rohitrayana123/VLSI/README.md

VLSI
====

VLSI design project

Useful Things
-------------

Found this plug-in for Chrome that will make Bibtex references for you

https://chrome.google.com/webstore/detail/bibtex-entry-from-url/mgpmgkhhbjgkpnanlmlhibjfgpdpgjec
