rohitrayana123/VLSI/Reports/FinalReport/Control_Design.tex

\section{Controller}
\label{sec:controller}

The controller is a Mealy machine used to sequence operations performed on the datapath.
Figure~\ref{fig:ControlBlock} contains all inputs, outputs and internal registers.
There are $7$ labelled inputs including two $4$ bit buses and one $8$ bit bus.
There are $26$ labelled outputs including five $2$ bit buses and one $3$ bit bus.
Typedefs, defined in a global file, are used for some single bit outputs and all bus outputs to keep decoding consistent in control and the datapath. 
Inputs from the datapath also use typedefs as these are defined by the instruction set. 

\begin{figure}[t]
   \centering
    
		\caption{Inputs, outputs and internal registers of the control block.}% \todo[inline]{Maybe change to IEEE symbols if we have time, AJR: we still have the eagle d-types but I think it would look a bit messy} }
   \label{fig:ControlBlock}
\end{figure}

Three main states exist to service the fetch, execute and interrupt stages.
Five sub states are used within the main states to further coordinate operation.
The substate binary values are gray coded to avoid glitches in memory access.
The ASM chart in Figure~\ref{fig:MainStateASM} describes state changes using the sub state, current opcode and interrupt request signal.   
State machines linked to the main state in Figures~\ref{fig:FetchASM} and ~\ref{fig:ExecuteASM} described the substate transitions.
The pruned Verilog in Listing~\ref{lst:ControlOverview.sv} explains how nested case statements are used to describes large amounts of logical operations. 
When \textit{nReset} is asserted the machine will asynchronously return to the first cycle of the fetch state.

\begin{figure}[ht]
   \centering
    
		\caption{ASM chart of controller main states.}
		\label{fig:MainStateASM}
\end{figure}

\begin{minipage}{\linewidth}
\lstinputlisting[style=sverilog,label=lst:ControlOverview.sv,caption=Reduced Verilog of control unit combinatorial logic.]{Code/ControlOverview.sv}
\end{minipage}

\subsection{Fetch}

Fetching an instruction from memory requires placing the program counter on the address bus then reading the instruction in to the instruction register. 
The state machine described in Figure~\ref{fig:FetchASM} asserts signals associated with memory access and delays if the slow memory access input, \textit{nWait}, is set.
When the transition from \textbf{cycle3} to \textbf{cycle0} is made the main state machine, Figure~\ref{fig:MainStateASM}, also makes a transition therefore severing the link to this machine. 

\begin{figure}[ht]
   \centering
    
		\caption{ASM chart of sub state transitions in the fetch stage.}
		\label{fig:FetchASM}
\end{figure}

\subsection{Execute}

The instruction fetched from memory is decoded and executed in either $1$ or $4$ cycles.
This is a variable length stage dependant upon whether the instruction requires memory access.
After the instruction has been executed the \textit{IntReq} signal is checked to decide whether an interrupt has occurred.
If an interrupt has occurred the substate on exit is \textbf{cycle4} otherwise it is \textbf{cycle0} ready to perform another fetch. 

A large section of Listing~\ref{lst:ControlOverview.sv} contains control flow for output decoding in this stage.
The branch code is used during branch operations and also interrupt operations.
\begin{figure}[ht]
   \centering
    
		\caption{ASM chart of sub state transitions in the execute stage.}
		\label{fig:ExecuteASM}
\end{figure}

\subsection{Interrupt}

The circuit in Figure~\ref{fig:IntReqCircuit} is used to generate an interrupt request.
To avoid problems introduced by metastability the external \textit{nIRQ} signal is retimed using two D-types.
\textit{IntEnable} can only be set in code using the \textbf{ENAI} instruction.
\textit{IntDisable} is set when the processor is interrupted and also in code using the \textbf{DISI} instruction.
The end register contains \textit{IntStatus} which is low at reset therefore interrupts are off by default. 

\begin{figure}[ht]
   \centering
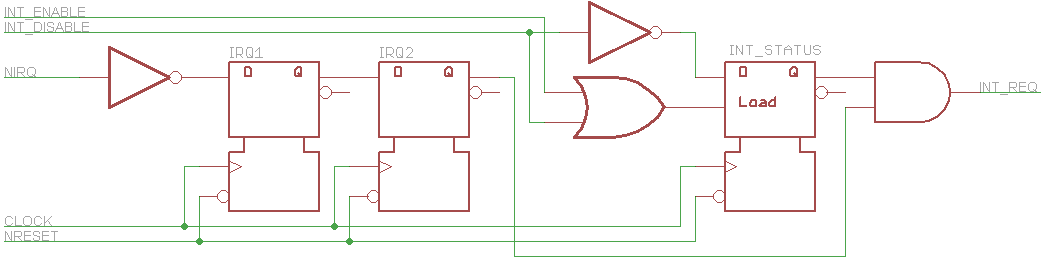
[picture p1: Reports/FinalReport/Figures/Interrupt.png]
    
		\caption{IntReq generation circuit.}
		\label{fig:IntReqCircuit}
\end{figure}

Entering an interrupt service routine (ISR) is completely handled in hardware. 
Interrupts are disabled and override functionality is used to decrement the stack pointer therefore allowing the program counter to be pushed to the stack.
The program counter is forced to address $0x0010$ which contains the code for ISR. 
The first operation in the ISR is \textbf{STF} which places the flags, located in the control unit, on the stack.

The penultimate operation in the ISR should be \textbf{LDF}. This loads the flags back in to the control unit.
This is similar to a \textbf{POP} operation but writes to the control unit instead of a general purpose register. 
The final operation is a \textbf{RETI} which again is similar to a \textbf{POP}, but writes to the program counter.

A bidirectional data interface to the control unit is required to facilitate these operations. 
Figure~\ref{fig:FlagCircuit} contains the circuit used to load and store flags inside the control unit.
The $4$ bit word containing the flags can be sourced from either the ALU or the bottom bits of \emph{SysBus}. 
When storing the flags in memory the output of the status register must be placed on \emph{SysBus} where the upper $12$ bits are all set to zero.

\begin{figure}[ht]
   \centering
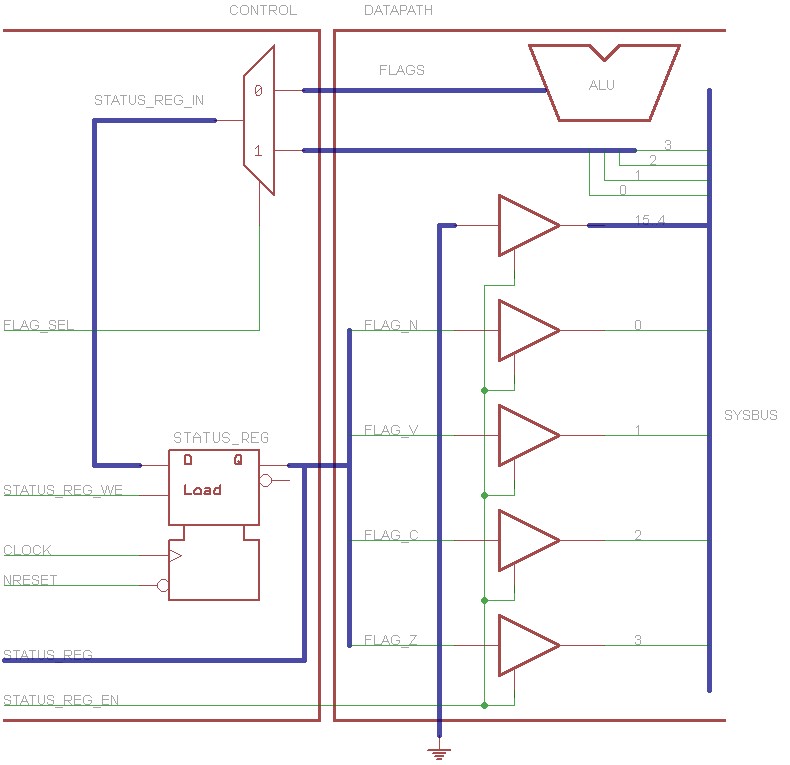
[picture p2: Reports/FinalReport/Figures/ControlIF.png]
    
		\caption{Control unit flag interface.}
		\label{fig:FlagCircuit}
\end{figure}

\subsection{Synthesis}

The controller was synthesised using Cadence Encounter. 
This provided a gate level netlist which was then used for place and route.
Both Magic and L-Edit place and route tools were used. 

The Magic place and route algorithm had a considerably larger routing channel than L-Edit algorithm as the cells were all placed in one long row. 
This was suboptimal as it resulted in a lot of dead space within the floorplan.

The L-Edit place and route provided far better results. 
The datapath and controller were approximately the same width. 
The I/Os were able to be positioned around the module to reduce the overall wiring needed in the full floor plan. 
Most of the datapath control signals were routed to the top of the module to reduce the wiring channel needed between the controller and datapath.
All the memory access signals were routed to the left of the controller to make easier connections to the pad ring. 
The controller was also connected to the low nibble of the input data. 
This was connected at the bottom of the controller to reduce wiring needed. 
Finally, decoder signals and flag inputs were routed to the right of the control.
