rohitrayana123/VLSI/Reports/FinalReport/Figures/MainStateASM.pdf

## Fetch

## Execute

## Interrupt

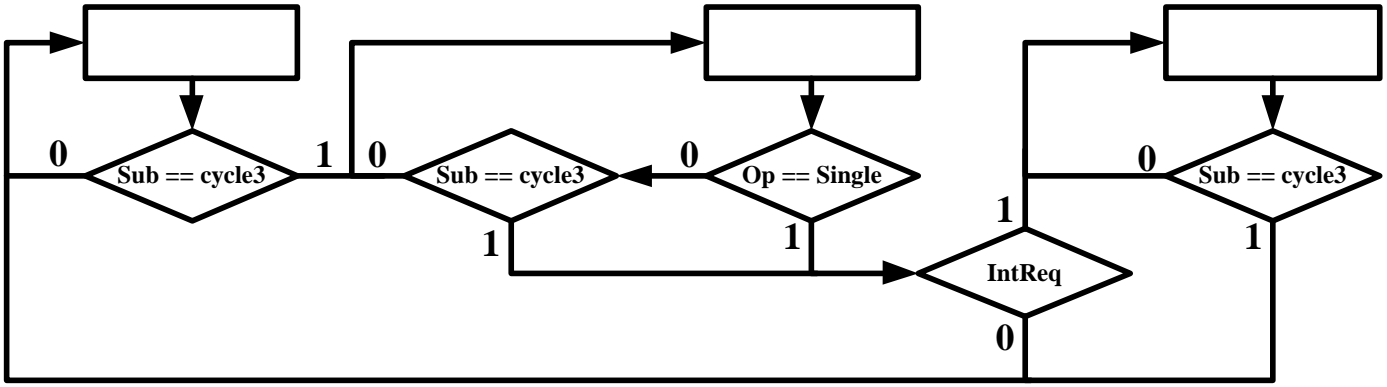
[picture p8: figure]
Sub == cycle3; Op == Single; IntReq; Sub == cycle3 0
