rohitrayana123/VLSI/Research/Subroutines/Subroutines.pdf

# ELEC6027: VLSI Design Project Part 1: Microprocessor Research Topic: Subroutines

### Ashley Robinson Team: R4 Course Tutor: Mr B. Iain McNally

### 18th February, 2014

## Contents

1 Introduction | 2
2 Research | 2
3 Case Studies | 4
4 Conclusion | 7
References | 9
Bibliography | 9

1

## 1 Introduction

Subroutines, also known as procedures, methods, functions or just routines, are smaller sections of code inside larger programs designed to perform specific tasks [2]. The motivation for subroutines is to produce code which is more efficient in size, easy to adapt and above all else maintain. They help form the foundations of third generation programming languages.
This report discusses the implications of subroutine support in hardware by considering microprocessor architecture and targeted assembler. Designing hardware such that it is capable of executing subroutines only requires available memory and access to the current position in the program; usually a register called the Program Counter (PC). Designing hardware to call and return from subroutines efficiently can vastly improve program performance. Two pieces of code will be referred to throughout this report. The caller is the piece of code which jumps to another piece of code and finally will return to continue execution. The callee is a piece of code jumped to from the caller and contains the functionality of a subroutine. While all subroutines considered a leaf functions the callee is not explicitly the whole subroutine as both pieces code are required for execution.

## 2 Research

### 2.1 Subroutine Context Save

Context save allows a microprocessor to switch execution focus but retain data such that the previous focus can be fully restored. Using call and return instructions when running a subroutine may automatically save context, such as the PC, but may also require additional instructions to guarantee safe execution. Nested and recursive subroutines, introduced in [4], require dealing with multiple context saves while retaining the data for all previous calls. Listing 1 holds subroutine written in C that recursively calls itself to compute the factorial of a number. Such applications require context save support that permits many nested subroutines.

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

Listing 1: Factorial subroutine

A stack, as discussed in [6], is a Last-In-First-Out (LIFO) data structure which is used for data storage when the immediately accessible registers do not provide enough memory. The stack can be thought of to grow in

2

size where a register called a Stack Pointer (SP) holds the address, in main memory, of the top most element. Two operations can be performed on the stack; push, which adds an item to the stack and increments the stack pointer, together with pull, which performs the reverse therefore shrinking the stack. It is convention for the stack to occupy main memory and grow down from the top address towards memory allocated for other purposes; this can be seen in figure 1. Data can be accessed indirectly on the stack using standard load and store instructions. If the top of the stack is known then relative addressing can be used to go back and forth without having to change the SP. Rewriting data in the stack is considered bad practice although is usually possible and can be exploited when writing subroutines.

Reserved

Text

Static data

Stack

0...0

F...F

SP

Dynamic data

Figure 1: Allocation of the stack in main memory. Based on a MIPS architecture adapted from [6].

Context save can also be handled by the assembler code running on the processor. Function prologues and epilogues, considered in [13, 9], are used to move data for safe execution. These follow conventions which usually advice the programmer on what register to place on the stack and how to do so from the caller and callee.

### 2.2 Operation of Stack Frames

A stack frame is a method of ordering data used when a subroutine is called. It is created by both the caller and the callee. It holds the paramters passed to the subroutine, the return address which should pointer at the caller and local variables created inside the callee. Figure 2 is a call stack; a stack of stack frames created by nesting subroutines. This is generally the case for most programs but optimisation can be used to improve memory allocation. Explained in [12], overlapping can be used to pass local variables on

3

to a nested subroutine by merging the parameter and local variable sections. Data returned from a function can be accessed using load instructions with addresses previously occupied by the stack.
Support for stack frames may be provided by a Base Pointer (BP). This usually takes on the value of the SP when the return address is placed on the stack therefore no calculations have to be done in order to destroy the local variable part of stack frame, just a simple overwrite.

Locals of FuncB

Return address

Parameters of FuncB

Locals of FuncA

Return address

Parameters of FuncA

To top of
stack

To bottom
of stack

Stack
frame for
FuncA
subroutine

Stack
frame for
FuncB
subroutine

Figure 2: An example call stack built of two stack frames where FuncA is called first. Adapted from [12].

## 3 Case Studies

### 3.1 Intel 8086

The Intel 8086 is a 16-bit Complex Instruction Set Computer (CISC) microprocessor which sparked the well kown x86 Intel family. It has support for procedure call instructions which automatically use the stack to organise data. The assembler held in listing 2 and 3 is written for the 8086. This is a basic example of how stack frames are built to pass parameters to and from a subroutine. The main program in listing 2 loads two immediate values into registers then begins building a stack frame by pushing them to the stack. The subroutine is called to act upon the arguments passed via the

4

stack. When control is passed back to the caller these set of instructions and the return value is extracted by using relative addressing from the BP then finally two stack pops completely destroy the stack frame. It is also possible to destroy the stack frame by using an add instruction on the SP shrinking it by one entry for every addition of two.

main : | ; Main l o o p
MOV | bp , sp | ; I n i t b a se p t r
MOV | ax , 4 2 | ; Load a r g 1
MOV | bx , 6 9 | ; Load a r g 2
PUSH | bx | ; Push a r g 1 t o s t a c k
PUSH | ax | ; Push a r g 2 t o s t a c k
CALL | adder | ; C all the s u b r o u ti n e
MOV | cx , [ bp−12] | ; Acce s s r e t u r n v al u e
POP | ax | ; R e s t o r e a l l r e g i s t e r s
POP | bx
JMP | main

Listing 2: 8086Caller.asm

When the subroutine, in listing 3, is called the return address is pushed onto the stack. This built-in support for the stack handles branching and next line address storage using a call function. To start the BP is placed on the stack so the SP has a restoration value. Reducing the value of the SP allocates space for local variables. The first argument is placed in memory as a local variable; this is unnecessary but serves as an example. The second argument is loaded into a working register. The first local variable is added to the working register which is then placed in to the memory as the second local variable. Finally the SP and the BP are restored and a return instruction hands control over to the caller. This is all part of the calling convention for subroutines using stack frames on the 8086 microprocessor [1].

adder PROC | | ; S u b r o u ti n e
PUSH | bp | ; Push b a se p t r t o s t a c k
MOV | bp , sp | ; Se t b a se p t r t o s t a c k p t r
SUB | sp , 4 | ; All o c a t e l o c a l v a r i a b l e sp ace ( 2 i n t s )
MOV | ax , [ bp+4] | ; Load a r g 1 i n t o Working
MOV | [ bp−2] , ax | ; Load a r g 1 i n t o L oc al 1
MOV | ax , [ bp+6] | ; Load a r g 2 i n t o Working
ADD | ax , [ bp−2] | ; Add t o c o n t e n t s o f working r e g
MOV | [ bp−4] , ax | ; Write L oc al 2 with r e s u l t
MOV | sp , bp | ; Return s t a c k p t r
POP | bp | ; R e s t o r e b a se p t r
RET | | ; Done
adder ENDP

Listing 3: 8086Callee.asm

5

This code was tested upon an 8086 emulator [11]. The emulator provides a complete overview of the flow of data within the processor including the stack. Figure 3a shows the emulator during the execution of the subroutine just before the SP is overwritten with the BP. Figure 3b is an abstraction of the stack with data labels corresponding to the subroutine.

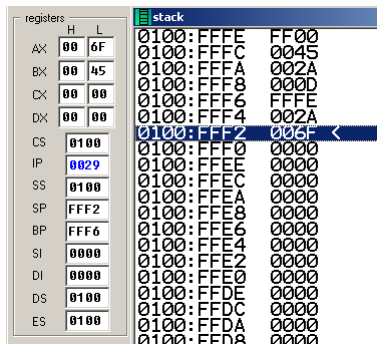
[picture p14: figure]

(a) Emulator registers and stack

arg2

arg1

PC

BP

local2

0xFFFC

0xFFFA

0xFFF8

0xFFF6

0xFFF4

Frame
Pointer

Stack
Pointer

local1

0xFFF2

0x0045

0x002A

0x000D

0xFFFE

0x002A

0x006F

(b) Stack frame configuration

Figure 3: 8086 stack operation

### 3.2 ARM7TDMI (using Arm Thumb)

The ARM7TDMI is a 32-bit Reduced Instruction Set Computer (RISC) microprocessor with an emphasis on low-power design and pipelining for high throughput which is detailed in [7]. It has two instruction sets. One of which is Arm Thumb, explained in [8], a low density compressed 16-bit subset of the ARM assembler language where the benefits are considered in [3]. It most notably assisted ARM into moving into the mobile phone market by reducing required program memory. A user selectable flag is set to switch between instruction sets.
This architecture does not have built-in support for calling subroutines using the stack. When the branch instruction is used, as seen in listing 4, the PC is overwritten with the address of the corresponding label. The address of the next line of code, which should be returned to after the subroutine, is placed into the link register (LR). Calling conventions suggests leaving this register untouched and simply moving the data back into the PC on a return.

6

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

Listing 4: ArmCaller.asm

In this case the LR is pushed onto the stack from the subroutine therefore requiring the subroutine to pop the value into the PC in order to return. This is an example of important assembler context save. If the prologue and epilogue are not respected then a call stack is never built therefore no nested functions can be used.
Listing 5 holds the subroutine and handles placing the return address on the stack. Relative addressing on the stack is required to draw the two arguments out and replace the first with the output of the function. Although this subroutine performs the same task as code held in listing 3 only one local variable is used as the example with two local variables is never really required.
adder PUSH | l r | ; Link r e g i s t e r h ol d s r e t u r n a d d r e s s
| SUB | sp , sp ,#4 | ; Make s p ace f o r l o c a l s on the s t a c k
LDR | r0 , [ sp ,# 1 2] | ; Get a r g 1 o f f s t a c k
LDR | r1 , [ sp ,# 8] | ; Get a r g 2 o f f s t a c k
| ADD | r0 , r0 , r 1 | ; Do the add
STR | r0 , [ sp ,# 0] | ; S t o r e the add a s a l o c a l
| ADD | sp , sp ,#4 | ; De s t roy l o c a l v a r i a b l e s p ace
| POP | pc | ; R e s t o r e program c o u n t e r and r e t u r n

Listing 5: ArmCallee.asm

## 4 Conclusion

It is clear that whether a microprocessor has built-in support for stack frames or not that the ability to call subroutines is unaffected. Support makes calling more efficient and easier to code. Essentially the matter is a trade off between complexity and efficiency.

7

### 4.1 Design Recommendations

All instruction sets considered in this report are 16-bits in length and could possibly be ported straight to the microprocessor to be designed. The 8086 is a pre-RISC architecture that can be considered as a quite a simple CISC processor [5]. RISC processors are simpler to construct as they have an emphasis on software; a comparison drawn in [10]. This would make the hardware easier to design but programs written for the end processor would be larger. So a RISC processor would most likely not provide built-in support for the stack but a CISC processor would; just like the case studies in section 3. A RISC processor is the intended architecture to implement the recommendation given is not to provide support but use instructions similar to those in the ARM Thumb instruction set. This would require designing an LR that can be used as shown in listings 4 and 3.

## References

[1] J. Archibald. The c calling convention and the 8086: Using the stack frame. http://ece425web.groups.et.byu.net/stable/labs/StackFrame.html, 2013. Online. Acessed Feb 2014.
[2] A. Chaney. | Subroutine. | https://www.princeton.edu/~achaney/
tmve/wiki100k/docs/Subroutine.html, Oct 2013. Online. Acessed Feb 2014.
[3] M. Hugue. Don’t we all need arms? http://www.cs.umd.edu/class/fall2001/cmsc411/proj01/arm/, 2001. Online, Acessed Feb 2014.
[4] B. I. McNally. Vlsi group design project: Programs. https://secure.ecs.soton.ac.uk/notes/bim/notes/fcde/assign/programs.html, Jan 2012. Online, Acessed Feb 2014.
[5] B. I. McNally. | Vlsi group design project: | Microprocessor re-
search. https://secure.ecs.soton.ac.uk/notes/bim/notes/fcde/assign/resdoc_14.html, 2014. Online, Acessed Feb 2014.
[6] D. Patterson and J. Hennessy. Computer Organization and Design, Fourth Edition, Fourth Edition: The Hardware/Software Interface (The Morgan Kaufmann Series in Computer Architecture and Design). Morgan Kaufmann, 4th edition, 2008. pp114–121.
[7] ARM Holdings plc. Arm7tdmi data sheet. http://www.ndsretro.com/download/ARM7TDMI.pdf, Aug 1995. Online. Acessed Feb 2014.

8

[8] ARM Holdings plc. | Thumb instruction set quick reference
card. | http://www.eng.auburn.edu/~nelson/courses/elec5260_
6260/Thumb%20Instructions.pdf, Oct 2003. | Online. Acessed Feb
2014.
[9] J. B. Pollard. | The gen on function perilogues. | http:
//homepage.ntlworld.com./jonathan.deboynepollard/FGA/ function-perilogues.html, 2010. Online, Acessed Feb 2014.
[10] R. Roberts. Risc vs cisc. http://cs.stanford.edu/people/eroberts/courses/soco/projects/risc/risccisc/, 2006. Online, Acessed Feb 2014.
[11] D. Sedory, R. Hyde, E. Isaacson, B. Allyn, T. Grysztar, S. Coval,
B. Brodt, J. Russell, and J. Gordonii. emu8086. http://www.emu8086.com/, 2013. Online. Acessed Feb 2014.
[12] Wikipedia. Call stack. http://en.wikipedia.org/wiki/Call_stack. Online, Acessed Feb 2014.
[13] Wikipedia. | Function prologue. | http://en.wikipedia.org/wiki/
Function_prologue. Online, Acessed Feb 2014.

## Bibliography

- ARM, Infocenter, http://infocenter.arm.com/help/index.jsp, Online. Acessed Feb 2014.
- A valuable resource for all things ARM.
- C. Lin, Understanding the Stack, http://www.cs.umd.edu/class/spring2003/cmsc311/Notes/Mips/stack.html, 2004, University of Maryland, Online. Acessed Feb 2014.
- General stack operation.
- S. Mathur, Microprocessor 8086: Architecture, Programming and Interfacing, PHI Learning Private Limited, 2011.
- Intel 8086 microprocessor resource
- B. I. McNally, Full Custom Design Exercise, http://users.ecs.soton.ac.uk/bim/notes/fcde/index.php, 2014.
- Plenty of information for ELEC6027

9

- D. Patterson and J. Hennessy, Computer Organisation and Design: The Hardware/Software Interface, Morgan Kaufman, 4th Edition, 2009.
- Lots of processor concepts and MIPS examples
- Wikipedia, MIPS architecture, http://en.wikipedia.org/wiki/MIPS_architecture, Online. Acessed Feb 2014.
- Quick information on the well studied MIPS processor.

10
