rohitrayana123/VLSI/Emulators/emu8086/binaries/readme.txt

	emu

        shareware, see licence.html

	yurim@nana10.co.il
