rohitrayana123/VLSI/Reports/FinalReport/CPU_Design.tex

%  CPU_Design.tex
%  Document created by seblovett on seblovett-Ubuntu
%  Date created: Thu 17 Apr 2014 15:14:45 BST
%  <+Last Edited: Thu 17 Apr 2014 15:36:00 BST by seblovett on seblovett-Ubuntu +>

\section{CPU}

%Overall layout 

The datapath and the control units were designed to allow them to connect together with as small a wiring channel as possible. 
All the I/Os were placed in each of the blocks to minimize the routing between the module and the pad ring. 
The pad ring used had a core size of $1505.00\mu m \times 1500.70\mu m$. 
The total size of the chip including the pad ring is $ 2150.00\mu m \times 2145.70\mu m$, a total area of $4.6mm^2$.

The controller was positioned below the datapath as it needed a connection to the lowest nibble of the system bus. 
The control signals between the datapath and controller were then placed to minimise the routing between them. 
This placement is at the expense of some control signals being routed to above the datapath. 

A net list was created and the magic autorouter was used.
This routed all the signals between the controller, datapath and the pad ring. 
The power lines were routed manually to the correct sizes. 

A large amount of polysilicon and the name of the processor, \textsc{Samurai}, is placed in the routing channels of the CPU to satisfy the design rule checks. 
A N-ohmic guard ring is also placed around the design and is connected to the core supply.
A large block of not\_pwell paint is used to explicitly define all undefined areas.
