rohitrayana123/VLSI/Documents/DeclarationofSpecialisms.pdf

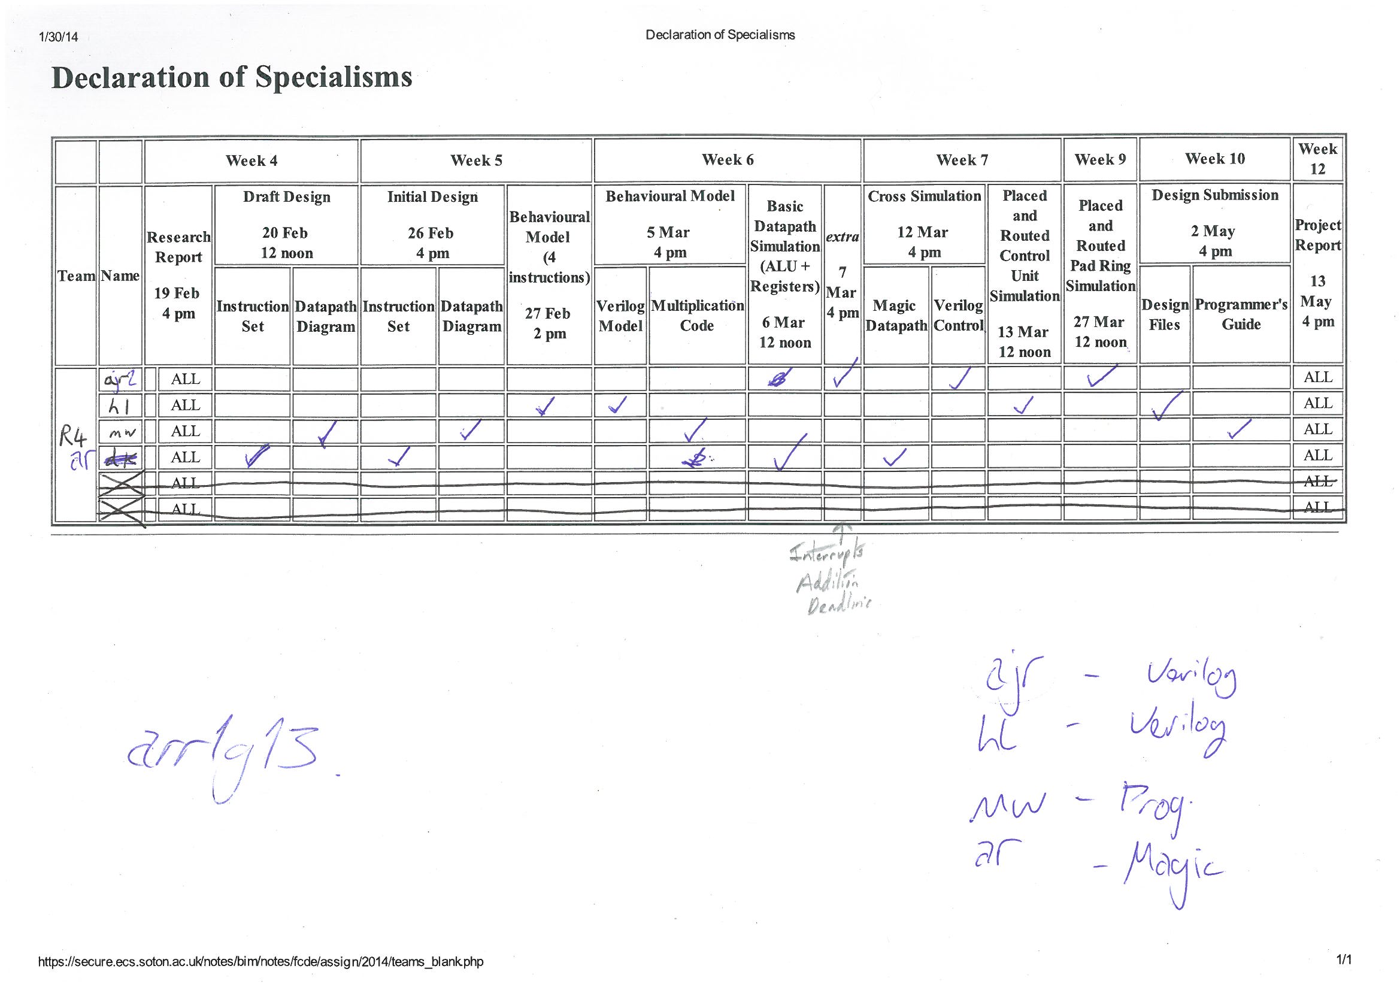
[picture p25: page 1]
