rohitrayana123/VLSI/Reports/FinalReport/ISSummary_page1.pdf

Mnemonic Syntax | Semantics | Flags Encoding Opcode Cond.
1 | ADD | ADD Rd, Ra, Rb | Rd ← Ra + Rb | c,v,n,z | A | 00010 | -
2 | ADDI | ADDI Rd, Ra, #imm5 | Rd ← Ra + imm5 | c,v,n,z | A | 00110 | -
3 | ADDIB | ADDIB Rd, #imm8 | Rd ← Rd + imm8 | c,v,n,z | B | 00011 | -
4 | ADC | ADC Rd, Ra, Rb | Rd ← Ra + Rb + c | c,v,n,z | A | 00100 | -
5 | ADCI | ADCI Rd, Ra, #imm5 | Rd ← Ra + imm5 + c | c,v,n,z | A | 00101 | -
6 | NEG | NEG Rd, Ra | Rd ← 0 - Ra | c,v,n,z | A | 11010 | -
7 | SUB | SUB Rd, Ra, Rb | Rd ← Ra - Rb | c,v,n,z | A | 01010 | -
8 | SUBI | SUBI Rd, Ra, #imm5 | Rd ← Ra - imm5 | c,v,n,z | A | 01110 | -
9 | SUBIB | SUBIB Rd, #imm8 | Rd ← Rd - imm8 | c,v,n,z | B | 01011 | -
10 | SUC | SUC Rd, Ra, Rb | Rd ← Ra - Rb - c | c,v,n,z | A | 01100 | -
11 | SUCI | SUCI Rd, Ra, #imm5 | Rd ← Ra - imm5 - c | c,v,n,z | A | 01101 | -
12 | CMP | CMP Ra, Rb | Ra - Rb | c,v,n,z | A | 00111 | -
13 | CMPI | CMPI Ra, #imm5 | Ra - imm5 | c,v,n,z | A | 01111 | -
14 | AND | AND Rd, Ra, Rb | Rd ← Ra AND Rb | - | A | 10000 | -
15 | OR | OR Rd, Ra, Rb | Rd ← Ra OR Rb | - | A | 10001 | -
16 | XOR | XOR Rd, Ra, Rb | Rd ← Ra XOR Rb | - | A | 10011 | -
17 | NOT | NOT Rd, Ra | Rd ← NOT Ra | - | A | 10010 | -
18 | NAND | NAND Rd, Ra, Rb | Rd ← Ra NAND Rb | - | A | 10110 | -
19 | NOR | NOR Rd, Ra, Rb | Rd ← Ra NOR Rb | - | A | 10111 | -
20 | LSL | LSL Rd, Ra, #imm4 | Rd ← Ra << imm4 | - | A | 11111 | -
21 | LSR | LSR Rd, Ra, #imm4 | Rd ← Ra >> imm4 | - | A | 11101 | -
22 | ASR | ASR Rd, Ra, #imm4 | Rd ← Ra >>> imm4 | - | A | 11100 | -
23 | LDW | LDW Rd, [Ra, #imm5] | Rd ← Mem[Ra + imm5] | - | C | 00000 | -
24 | STW | SDW Rd, [Ra, #imm5] | Mem[Ra + imm5] ← Rd | - | C | 01000 | -
25 | LUI | LUI Rd, #imm8 | Rd ← {imm8, 0} | - | B | 10100 | -
26 | LLI | LLI Rd, #imm8 | Rd ← {Rd[15:8], imm8} | - | B | 10101 | -
27 | BR | BR LABEL | PC ← PC + imm8 | - | D | - | 000
28 | BNE | BNE LABEL | (z==0)? PC ← PC + imm8 | - | D | - | 110
29 | BE | BE LABEL | (z==1)? PC ← PC + imm8 | - | D | - | 111
30 | BLT | BLT LABEL | (n&~v OR ~n&v)? PC ← PC + imm8 | - | D | - | 100
31 | BGE | BGE LABEL | (n&v OR ~n&~v)? PC ← PC + imm8 | - | D | - | 101
32 | BWL | BWL LABEL | LR ← PC + 1; PC ← PC + imm8 | - | D | - | 011
33 | RET | RET | PC ← LR | - | D | - | 010
34 | JMP | JMP Ra, #imm5 | PC ← Ra + imm5 | - | D | - | 001
| | PUSH Ra | Mem[R7] ← Ra; R7 ← R7 - 1;
| | PUSH LR | Mem[R7] ← RL; R7 ← R7 - 1;
| | POP Ra | R7 ← R7 + 1; Ra ← Mem[R7]
| | POP LR | R7 ← R7 + 1; RL ← Mem[R7]
37 | RETI | RETI | PC ← Mem[R7] | - | F | - | 000
38 | ENAI | ENAI | IntEnFlag ← 1 | - | F | - | 001
39 | DISI | DISI | IntEnFlag ← 0 | - | F | - | 010
40 | STF | STF | Mem[R7] ← Flags; R7 ← R7 - 1; | - | F | - | 011
41 | LDF | LDF | R7 ← R7 + 1; Mem[R7] ← Flags; | - | F | - | 100
E | - | -
E | - | -

35

36

PUSH

POP
