rohitrayana123/VLSI/Design/RandD/ajr_datapath.pdf

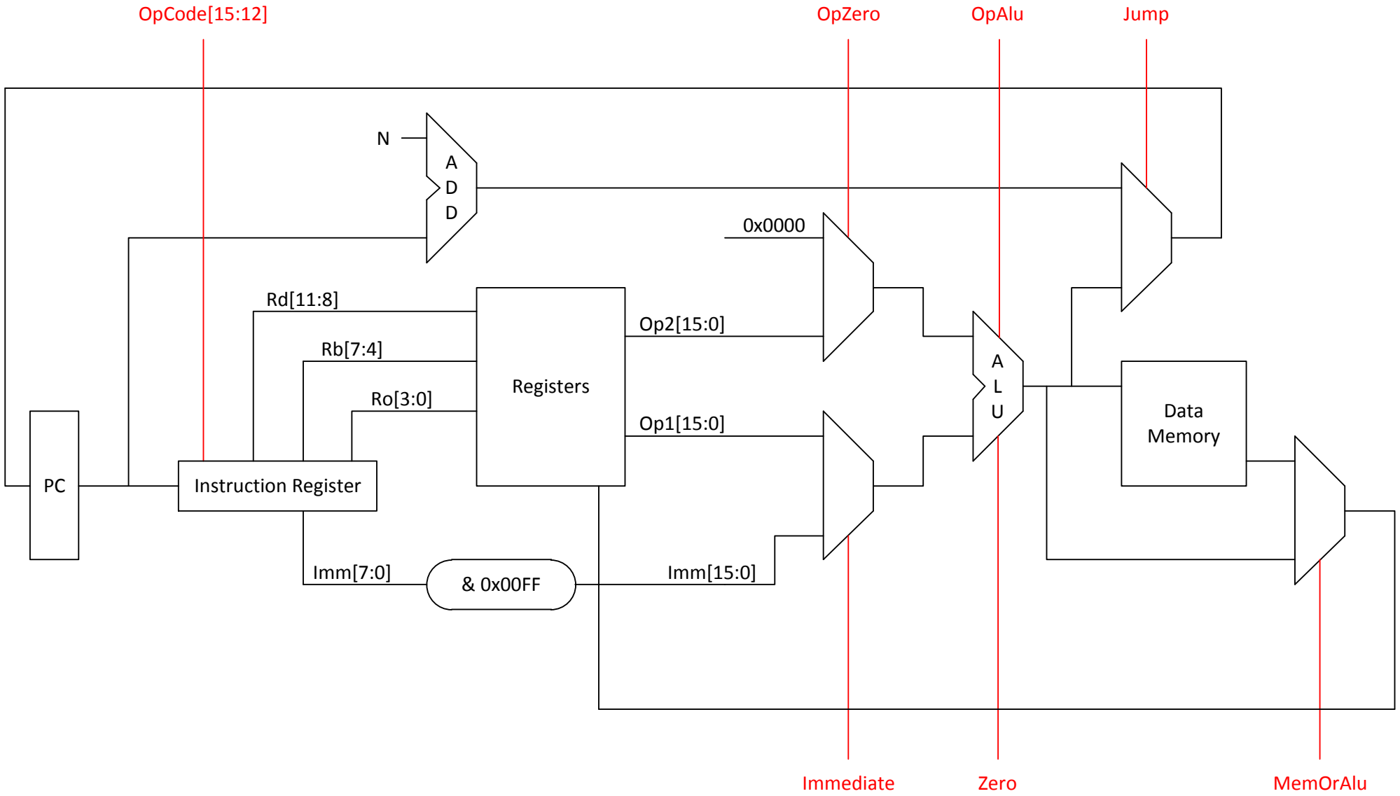
[picture p37: figure]
Registers; Data Memory; MemOrAlu; Jump; Zero; Instruction Register; OpCode[15:12]; Immediate; Imm[7:0]; OpZero; OpAlu; Imm[15:0] & 0x00FF
