rohitrayana123/VLSI/Reports/FinalReport/Figures/ExecuteASM.pdf

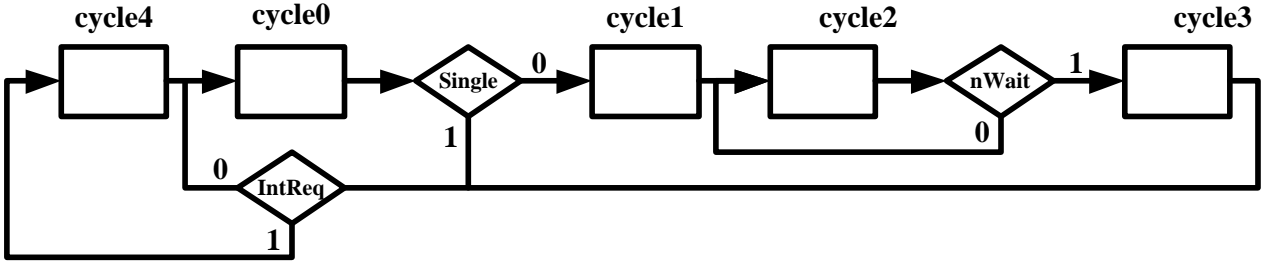
[picture p38: figure]
