rohitrayana123/VLSI/Reports/FinalReport/Figures/ControlPinout.pdf

O
p

c

o

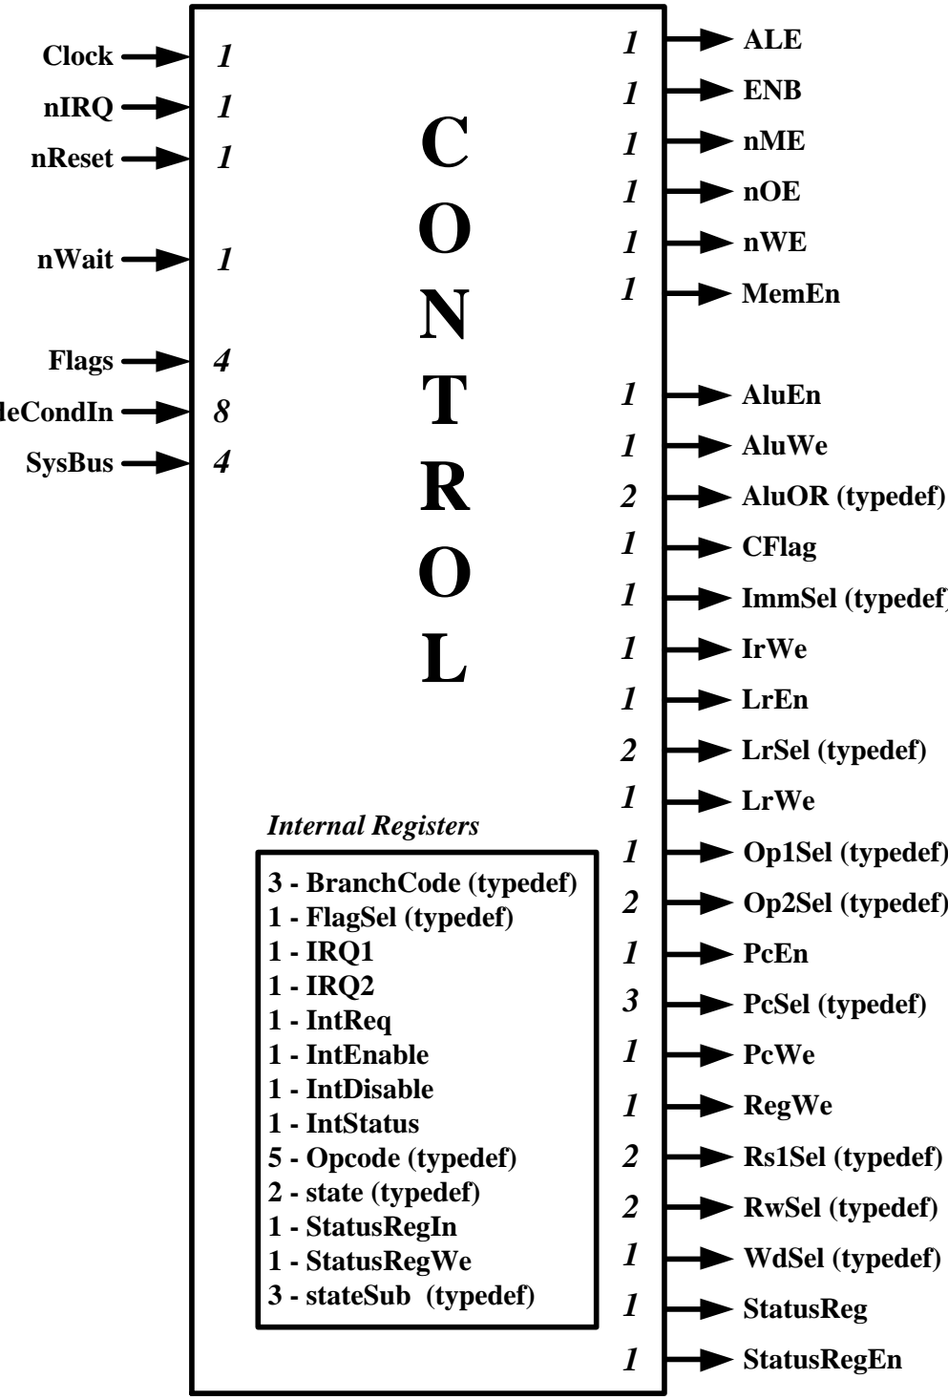
[picture p39: figure]
CONTROL

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
