rohitrayana123/VLSI/Research/Subroutines/Figures/Allocation.pdf

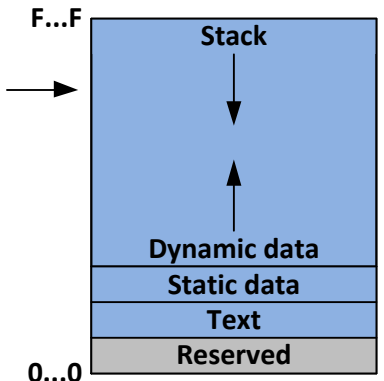
[picture p40: figure]
Reserved; Text; Static data; Stack; Dynamic data

0...0

SP
