rohitrayana123/VLSI/Design/RandD/henry_VNM_1.jpg

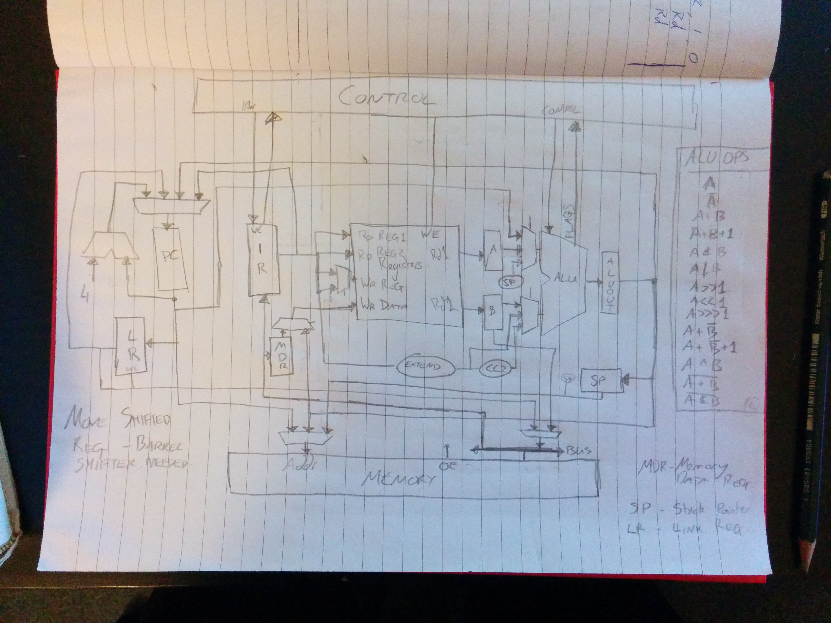
Design/RandD/henry_VNM_1.jpg
