rohitrayana123/VLSI/eagle/Datapath/datapath.png

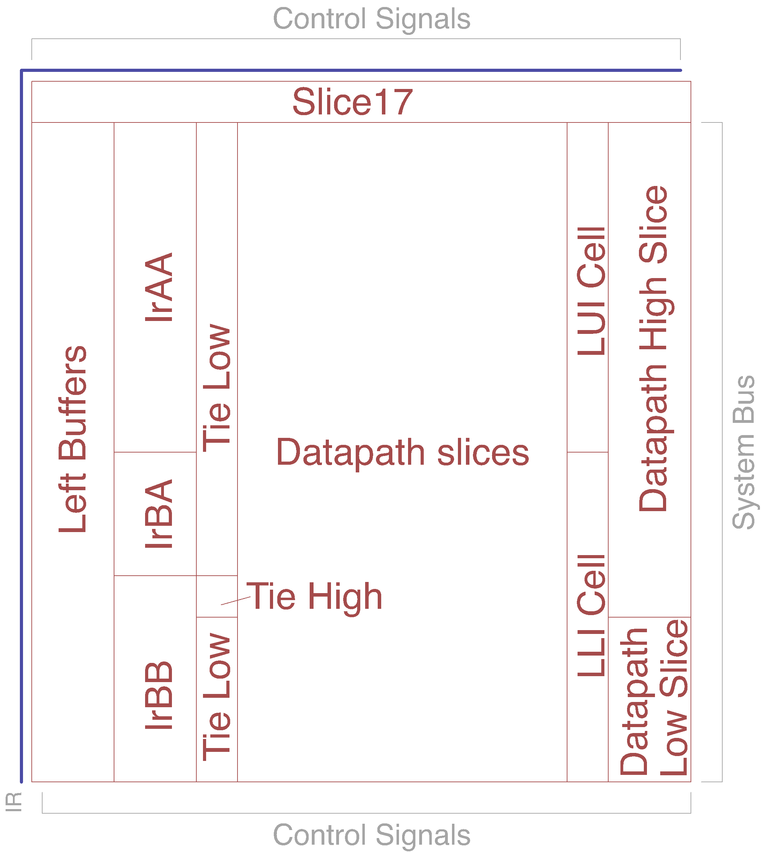
eagle/Datapath/datapath.png
