rohitrayana123/VLSI/Reports/FinalReport/Figures/ALUDecoderGateArray.png

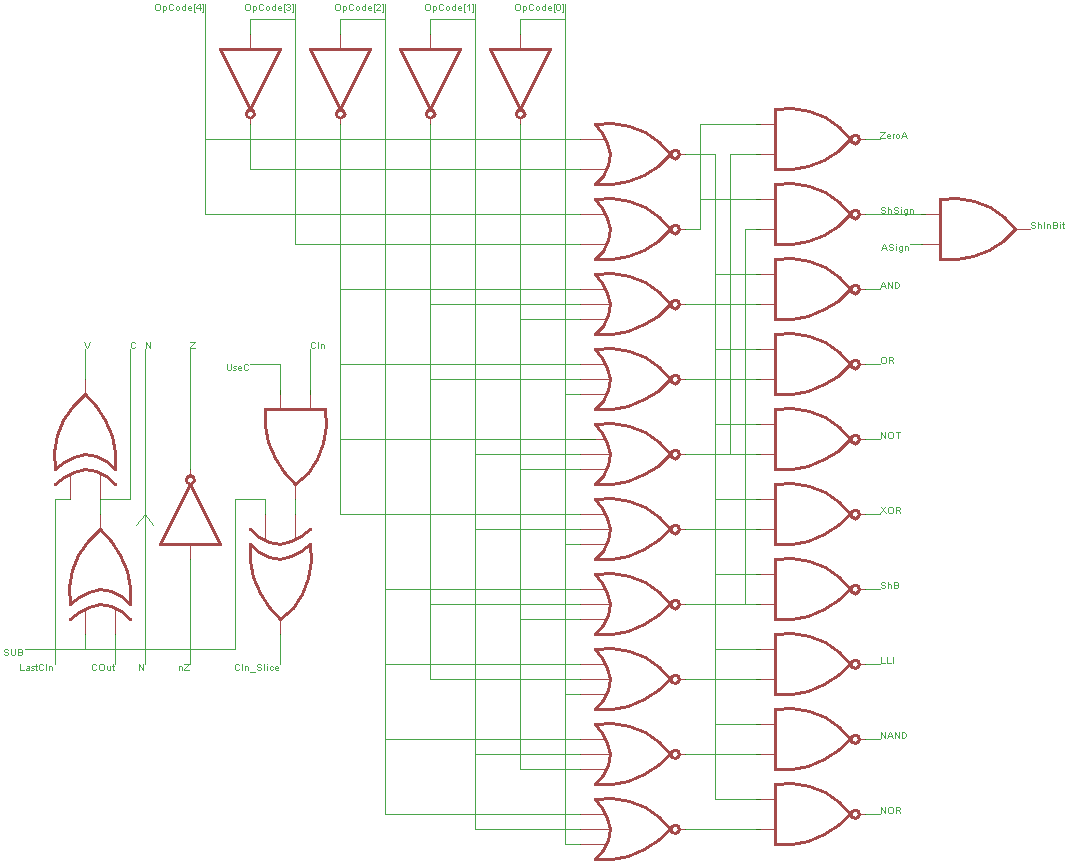
Reports/FinalReport/Figures/ALUDecoderGateArray.png
