rohitrayana123/VLSI/Reports/FinalReport/Figures/ALUDecoderMore1.png

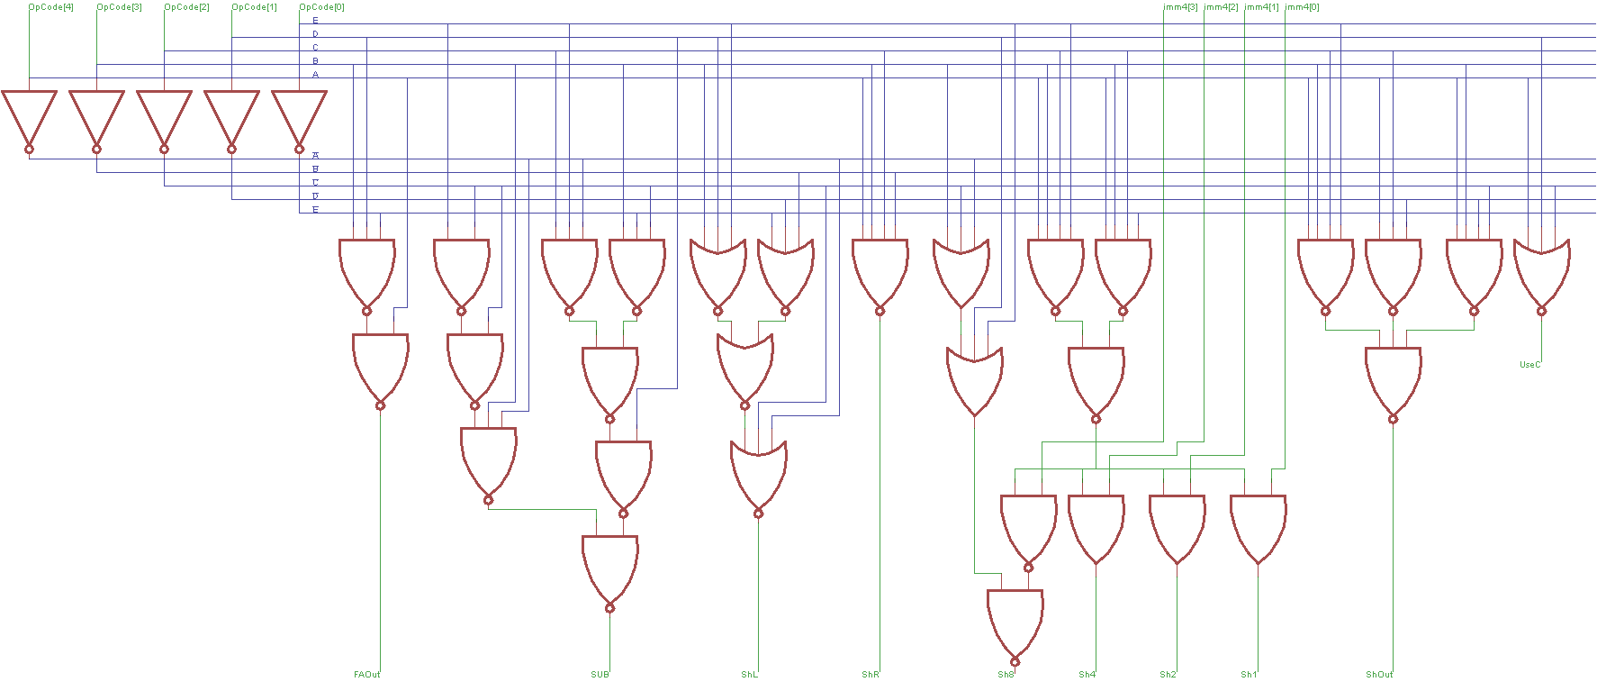
Reports/FinalReport/Figures/ALUDecoderMore1.png
