rohitrayana123/VLSI/Reports/FinalReport/Figures/LLILSlice.png

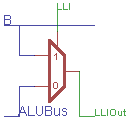
Reports/FinalReport/Figures/LLILSlice.png
