rohitrayana123/VLSI/Reports/ProgGuide/CodeListings.tex

\section{Code Listings}
All code listed in this section is passed to the assembler \emph{as is} and has been verfied using the final design of the processor.
\subsection{Multiply}
\label{sec:multiply_appendix}
\lstinputlisting[style=asm,label=lst:multiply.asm,caption=multiply.asm]{../../Design/Implementation/programs/multiply.asm}
%\subsection{Multiply Unrolled}
%\label{sec:multiply_unrolled_appendix}
%\lstinputlisting[style=asm,label=lst:multiplyUnroll.asm,caption=multiplyUnroll.asm]{../../Design/Implementation/programs/multiplyUnroll.asm}
\subsection{Factorial}
\label{sec:factorial_appendix}
\lstinputlisting[style=asm,label=lst:factorial.asm,caption=factorial.asm]{../../Design/Implementation/programs/factorial.asm}
\subsection{Random}
\label{sec:random_appendix}
\lstinputlisting[style=asm,label=lst:random.asm,caption=random.asm]{../../Design/Implementation/programs/random.asm}
\subsection{Interrupt}
\label{sec:interrupt_appendix}
\lstinputlisting[style=asm,label=lst:interrupt.asm,caption=interrupt.asm]{../../Design/Implementation/programs/interrupt.asm}
