rohitrayana123/VLSI/Reports/ProgGuide/ProgGuide.tex

%  ProgGuide.tex
%  Document created by seblovett on hind.ecs.soton.ac.uk
%  Date created: Thu 27 Mar 2014 10:09:06 GMT
%  <+Last Edited: Fri 02 May 2014 09:46:39 BST by seblovett on seblovett-Ubuntu +>

\documentclass[twoside,12pt]{article}

%\usepackage[nodayofweek]{datetime}
\usepackage{ISFormat}
\usepackage{multirow}
\usepackage[colorinlistoftodos,disable]{todonotes}
\usepackage[nodayofweek]{datetime}
\usepackage{listings}
\usepackage{graphicx}
\usepackage{titlesec}
\newcommand{\sectionbreak}{\cleardoublepage}
\usepackage[all]{background}
\usepackage{lipsum}
\usepackage{tikz}
\usetikzlibrary{calc}
\usepackage{changepage}
\usepackage{subfigure}
\graphicspath{{Figures/}}
\author{Team R4\\
Henry Lovett (hl13g10)\\ 
Ashey J. Robinson (ajr2g10)\\
Martin Wearn (mw20g10)\\
Anusha R. Reddy (arr1g13)\\ \\
Course Tutor: Mr B. Iain McNally\\ \\}

\title{ELEC6027 - VLSI Design Project \\ Programmers Guide}

\begin{document}
\maketitle
\thispagestyle{empty}
\input{definitions.tex}%import some definitions
\clearpage
%\listoftodos
%\todo[inline]{Run a spell check on all files}
%\begin{abstract}
%Abstract
%\end{abstract}
\cleardoublepage
\tableofcontents
\cleardoublepage
\input{Introduction.tex}
\input{Architecture.tex}
\input{RegDescription.tex}
\input{InstructionSet.tex}
\input{ProgrammingTips.tex}
\input{Assembler.tex}
\input{Programs.tex}
%\input{Simulation.tex}
\input{Simulation_SimPy.tex}
\newpage
\appendix
\input{CodeListings.tex}
\input{DeclarationofWork.tex}
\end{document}
