rohitrayana123/VLSI/Reports/ProgGuide/DeclarationofWork.tex

%  DeclarationofWork.tex
%  Document created by seblovett on seblovett-Ubuntu
%  Date created: Tue 29 Apr 2014 20:51:04 BST
%  <+Last Edited: Tue 29 Apr 2014 21:07:39 BST by seblovett on seblovett-Ubuntu +>

\section{Declaration of Work}

Table~\ref{tab:work} shows the break down of the work for this programming guide. 
Where multiple team members contributed to a section, approximate work percentages are given. 

\begin{table}[!h]
\caption{Work Breakdown for the Programmers Guide}
\label{tab:work}
\centering
\begin{tabular}{|c|c|} \hline
Chapter			&	User	\\ \hline
Introduction		&	hl13g10 \\	
Register Description	&	arr1g13 (50\%), hl13g10 (50\%) \\
Instruction Set		&	mw20g10	\\
Programming Tips	&	ajr2g10 (50\%), hl13g10 (50\%) \\		
Assembler		&	mw20g10 (75\%), hl13g10 (50\%) \\		
Programs		&	ajr2g10 \\
Simulation		&	hl13g10 \\
Code Listings		&	ajr2g10 \\ \hline
\end{tabular}
\end{table}
