rohitrayana123/VLSI/Design/InstructionSet/EncodingGuide.txt

This is the coding scheme I used when writing up the instruction set.

OpCodes:
	See KMap

Conditions:
Unconditional starts 0
	a 0 next uses link register
	a 1 next does not use link register
Conditional starts 1
	a 1 next checks z flag
	a 0 next does not check z flag
