rohitrayana123/VLSI/Reports/ProgGuide/Figures/twoStack.pdf

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
## RR0 R1 R2 R3 R4

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
