rohitrayana123/VLSI/Research/InstructionSet/8086Format_cropped.pdf

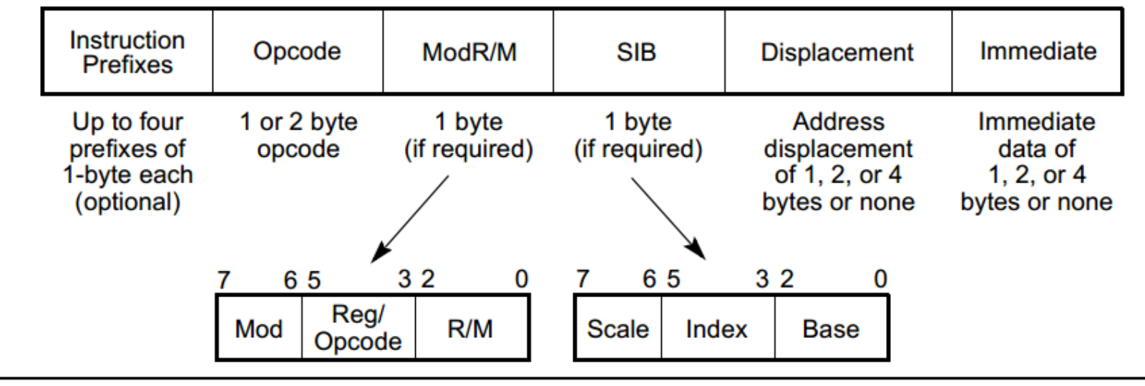
[picture p50: page 1]
