rohitrayana123/VLSI/Research/InstructionSet/AlphaFormat_cropped.pdf

Opcode | | | | | PAL code
Opcode | RA | | | | Branch
Opcode | RA | RB | | | Memory
Opcode | RA | RB | Func | RC | Operate
6 | 5 | 5 | 11 | 5 | Bit Count

Number
| Disp
| | Disp
