rohitrayana123/VLSI/Research/InstructionSet/Correlations_cropped.pdf

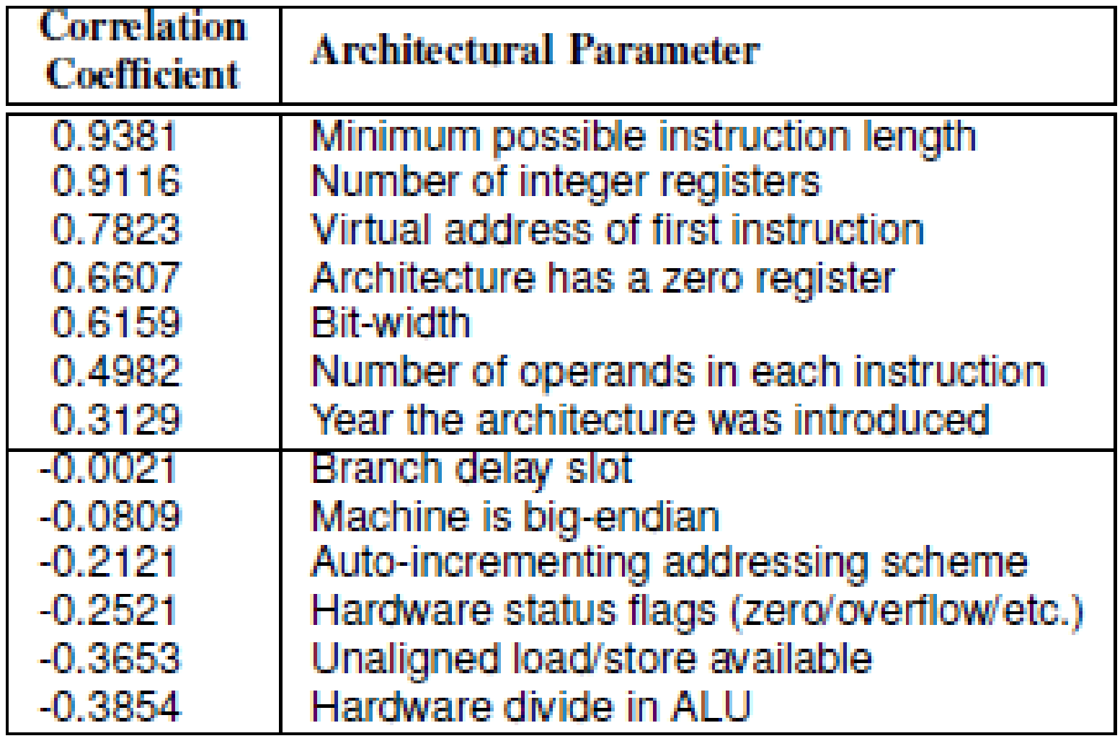
[picture p51: page 1]
