rohitrayana123/VLSI/Reports/FinalReport/PC_Test.tex

%  PC_Test.tex
%  <+Last Edited: Mon 12 May 2014 10:18:05 BST by seblovett on seblovett-Ubuntu +>

\section{Program Counter}
%\todo[color=cyan, inline]{Include Sub tests - of slice and decoder (if app)}
%\todo[color=cyan, inline]{Explain tests - what is done}
%\todo[color=cyan, inline]{why it is done.}
%\todo[color=cyan, inline]{How it verifies everything - why it is complete}
%\todo[color=cyan, inline]{Show simulation results}

This module contains both the program counter and link register, which could be tested independently by checking the response to different select signals. The PC was tested by setting \textit{PcSel} to each possible value, then causing a change in the value of that input to ensure the value of PC reflects the change. This covers incrementing, \textit{SysBus}, \textit{AluOut} and constant inputs. 
\todo[inline]{Extend tests for load from LR}

The link register was then tested in the same manner for loading from \textit{SysBus} and an incremented program counter value. 
The value of each register was read from the system bus with assertions to ensure correct behaviour. 

\incomplete{PC block test}
