rohitrayana123/VLSI/Reports/FinalReport/Register_Test.tex

%  Register_Test.tex
%  <+Last Edited: Mon 12 May 2014 10:26:45 BST by seblovett on seblovett-Ubuntu +>

\section{Register Block}

%Include Sub tests - of slice and decoder (if app)
Tests were implemented for the decoder and bitslice modules implemented in Magic. 
A full module test was also written. 
The same test was designed to be run on both the Magic layout and the behavioural SystemVerilog design. 
This allowed the full operation of the behavioural model and implemented layout to be verified to the same standard. 

The bitslice test loads one bit of data into each register, and checks that it can be read back on each of the data read lines.
Assertions are used to automate the checking of the bit slice.

The decoder is verified by exercising all the possible inputs to each of the decoders.
The one hot encoding output is then checked to be as expected for the current input. %correct to the input.
This is repeated for each read decoder, and the write decoder is verified to only output correctly when the write enable signal is high. 

The full test uses a ``task'' code block to write to a register and read the data back.
The data is then verified to be correct on both read ports.
This process is repeated 100 times to exercise different data on all the registers. 
Assertions are used to give a final pass/fail result allowing quick verification of the module.
The tests ensure the read buffers and the writing to each register is fully functional.

%why it is done.

%How it verifies everything - why it is complete
