rohitrayana123/VLSI/Reports/FinalReport/Testing.tex

%  Testing.tex
%  Document created by seblovett on seblovett-Ubuntu
%  Date created: Thu 17 Apr 2014 15:23:39 BST
%  <+Last Edited: Thu 17 Apr 2014 17:34:00 BST by seblovett on seblovett-Ubuntu +>

\chapter{Testing}

\input{Register_Test.tex}
\input{PC_Test.tex}
\input{IR_Test.tex}
\input{ALU_Test.tex}
\input{Datapath_Test.tex}
\input{Control_Test.tex}
\input{CPU_Test.tex}
