rohitrayana123/VLSI/Reports/FinalReport/TestResults.tex

\chapter{Test Results}

\section{ALU Results}
\label{chap:ALUTestResults}

\begin{figure}[h]
	\centering
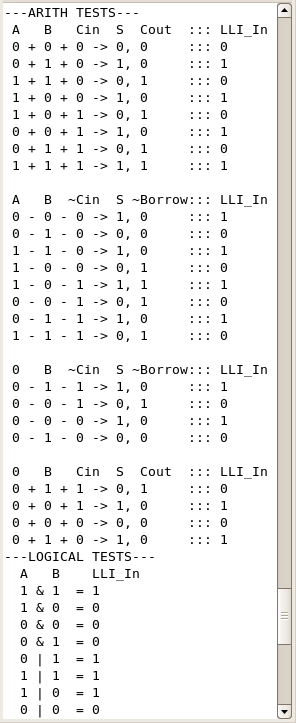
[picture p52: Reports/FinalReport/results/ALUSliceA.png]
	
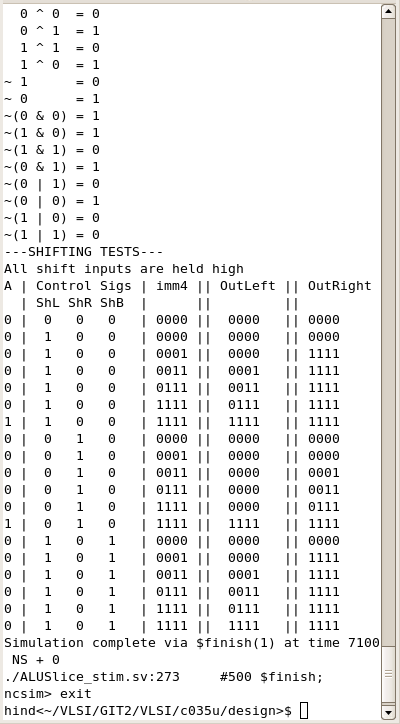
[picture p53: Reports/FinalReport/results/ALUSliceB.png]
	
	\caption{Test Results for ALUSlice}
	\label{fig:ALUSliceRes}
\end{figure}
\begin{figure}[h]
	\centering
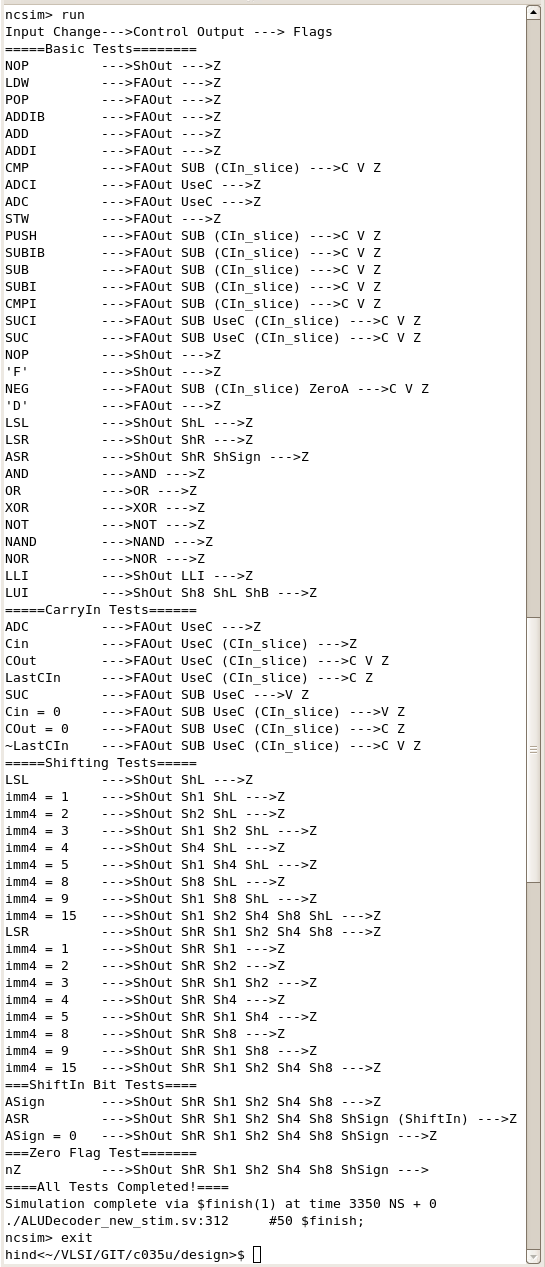
[picture p54: Reports/FinalReport/results/ALUDecoder.png]
	
	\caption{Test Results for ALUDecoder}
	\label{fig:ALUDecoderRes}
\end{figure}
\begin{figure}[h]
	\centering
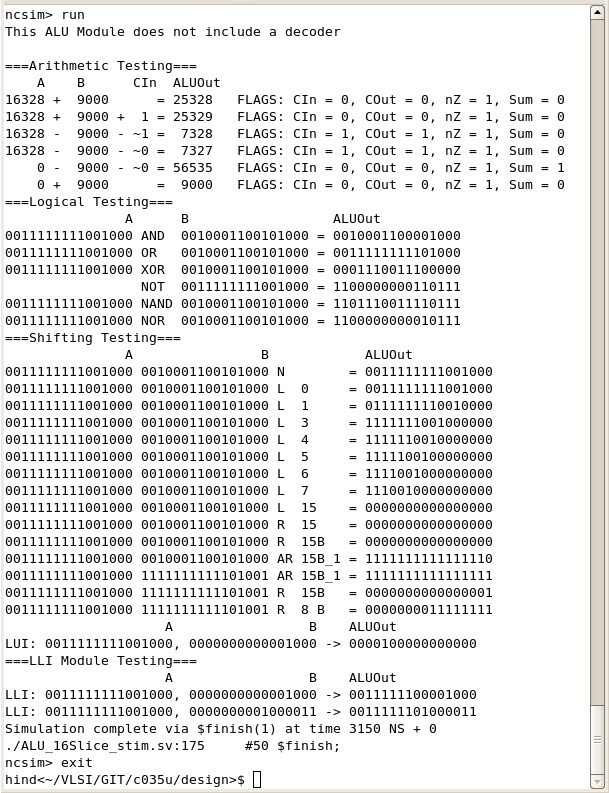
[picture p55: Reports/FinalReport/results/ALUBlock.png]
	
	\caption{Test Results for 16 Slice Block}
	\label{fig:ALUBlockRes}
\end{figure}
