rohitrayana123/VLSI/Reports/FinalReport/results/ALUDecoderA.png

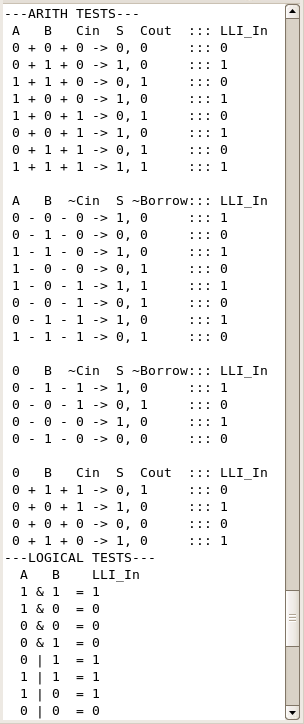
Reports/FinalReport/results/ALUDecoderA.png
