rohitrayana123/VLSI/Reports/FinalReport/results/ALUDecoderB.png

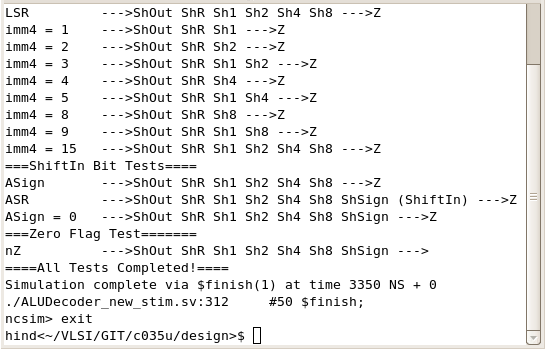
Reports/FinalReport/results/ALUDecoderB.png
