rohitrayana123/VLSI/Emulators/emu8086/_Recommendations/000 bug report 0202.txt

org 100h
aaa equ 80
bbb equ aaa-10

mov ax, [aaa-10]
mov ax, aaa-10

; bug #1
mov ax, bbb

mov bx, bbb

; bug #2
mov ch, bbb

mov cx, bbb

ret
