rohitrayana123/VLSI/Design/RandD/idea1.pdf

D

a

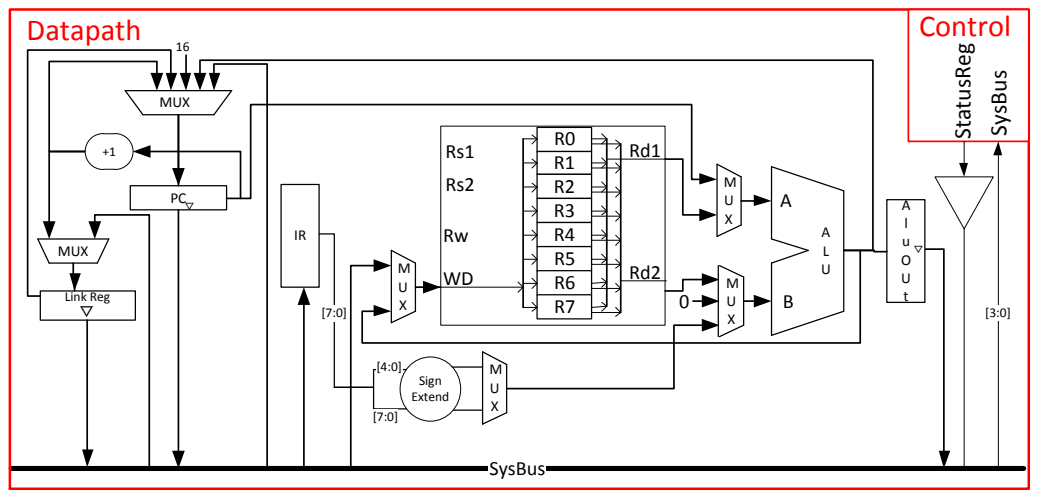
[picture p58: page 1]
wWD Rs2; ALU; MUX; StatusReg; AluOUt; SysBus
