rohitrayana123/VLSI/Design/RandD/Iain.pdf

R

s

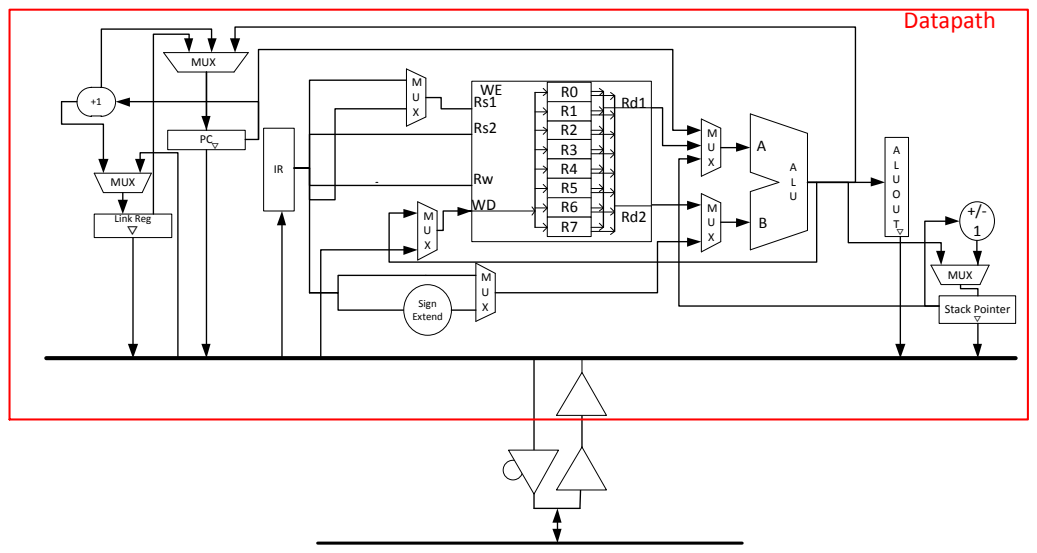
[picture p59: page 1]
ALU; MUX; ALUOUT; wWD Rs2
