rohitrayana123/VLSI/Design/RandD/Datapath1.pdf

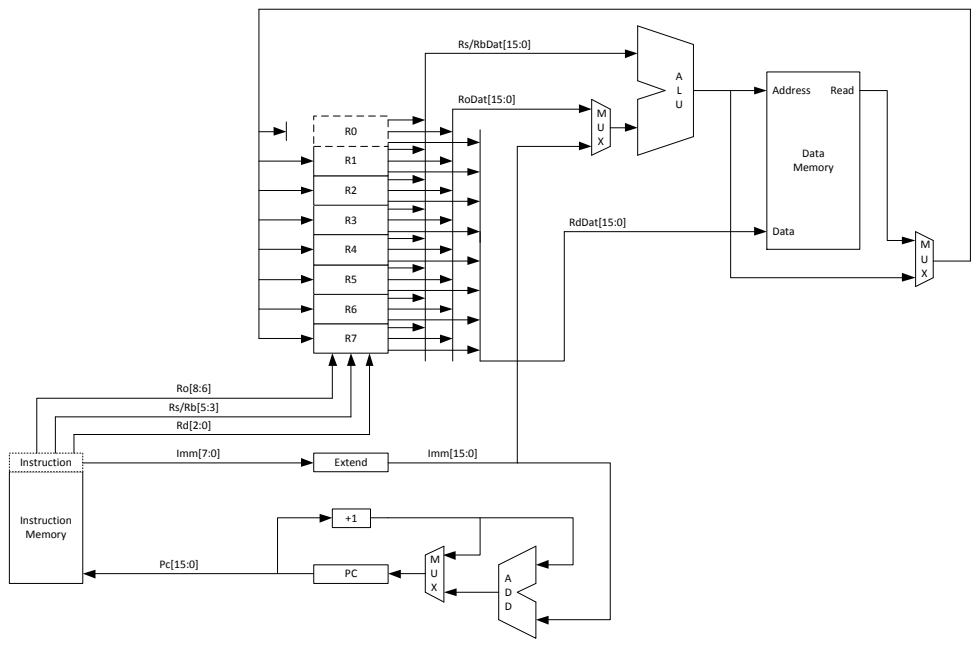
[picture p60: page 1]
MUX; ALU; ADD
