rohitrayana123/VLSI/Reports/ProgGuide/Figures/LFSR.pdf

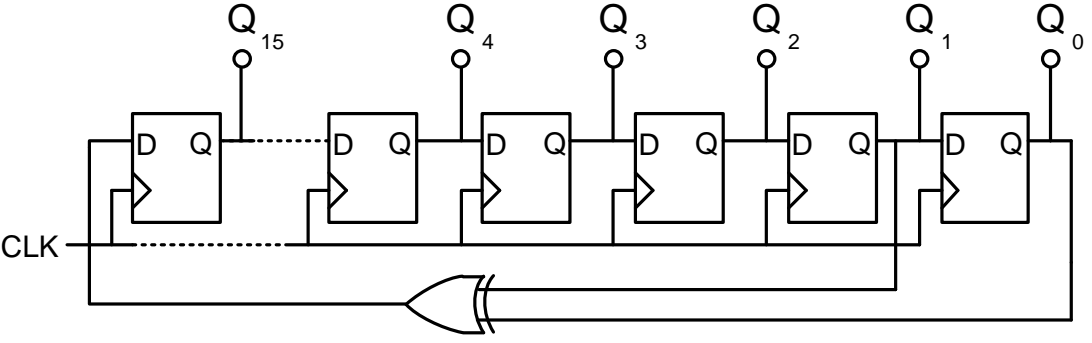
[picture p61: page 1]
CLK
