rohitrayana123/VLSI/eagle/ALU/ALUDecoderGateArrayv2.sch

## EAGLE design eagle/ALU/ALUDecoderGateArrayv2.sch (2014-05-12)

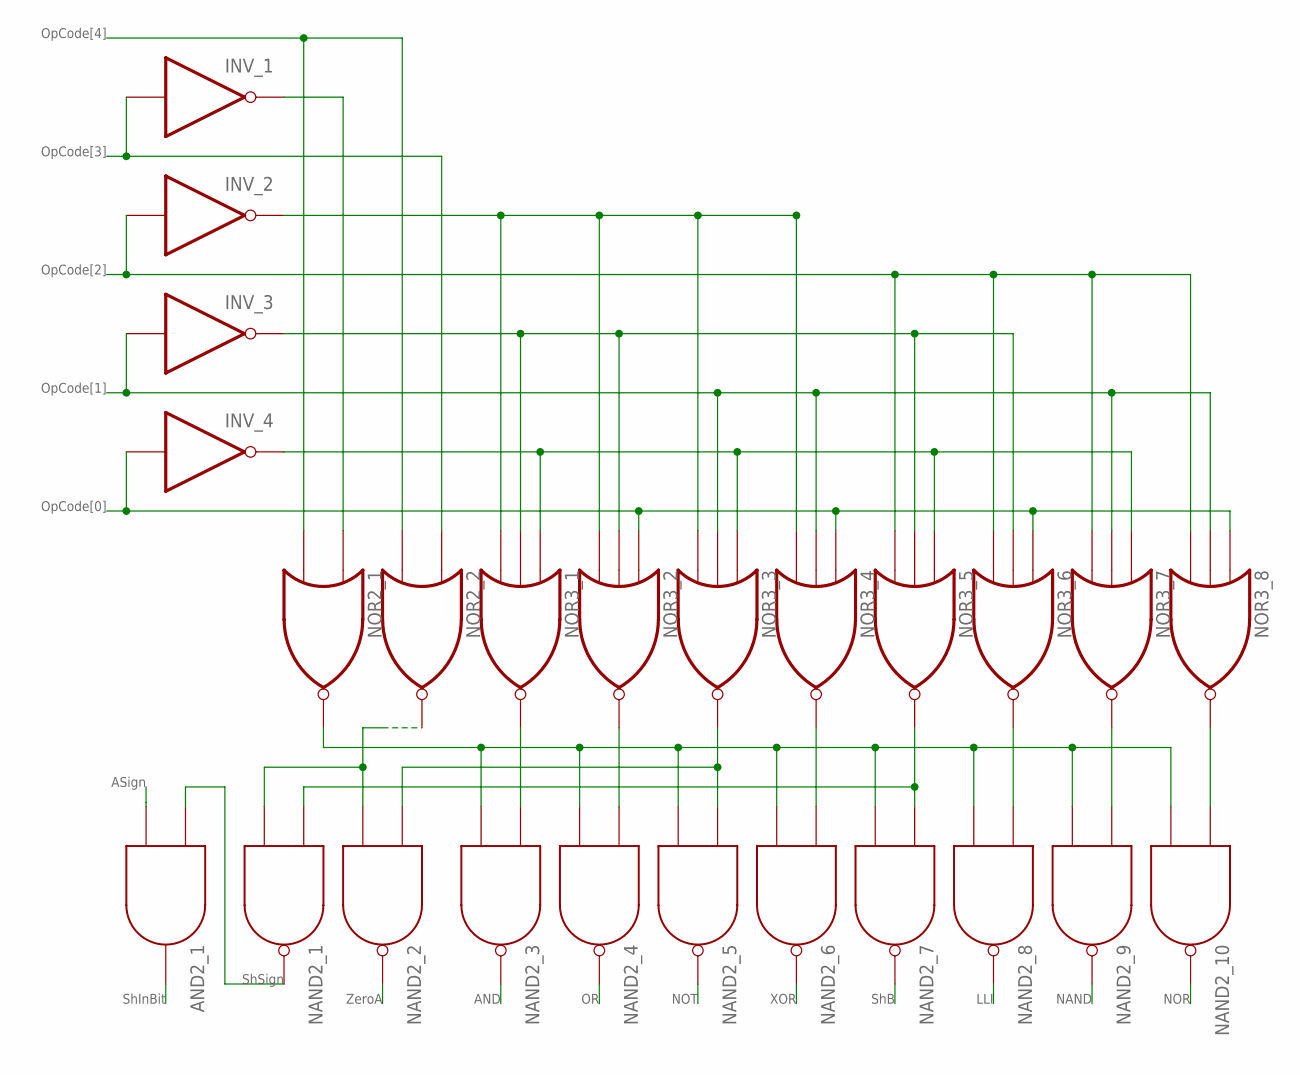
[picture p63: schematic ALUDecoderGateArrayv2.sch]

Parts:
AND2_1: AND2; 3PIN
INV_1, INV_2, INV_3, INV_4: INV; 3PIN
NAND2_1, NAND2_2, NAND2_3, NAND2_4, NAND2_5, NAND2_6, NAND2_7, NAND2_8, NAND2_9, NAND2_10: NAND2; 3PIN
NOR2_1, NOR2_2: NOR2; 3PIN
NOR3_1, NOR3_2, NOR3_3, NOR3_4, NOR3_5, NOR3_6, NOR3_7, NOR3_8: NOR3; 5PIN

Connections:
unnamed: NOR2_1.P$2 (I1), NOR2_2.P$2 (I1)
unnamed: INV_1.P$2 (O), NOR2_1.P$1 (I0)
unnamed: INV_2.P$1 (I), NOR3_5.P$2 (I1), NOR3_6.P$2 (I1), NOR3_7.P$2 (I1), NOR3_8.P$2 (I1)
unnamed: INV_2.P$2 (O), NOR3_1.P$2 (I1), NOR3_2.P$2 (I1), NOR3_3.P$2 (I1), NOR3_4.P$2 (I1)
unnamed: INV_3.P$2 (O), NOR3_1.P$3 (I2), NOR3_2.P$3 (I2), NOR3_5.P$3 (I2), NOR3_6.P$3 (I2)
unnamed: INV_4.P$2 (O), NOR3_1.P$1 (I0), NOR3_3.P$1 (I0), NOR3_5.P$1 (I0), NOR3_7.P$1 (I0)
unnamed: INV_4.P$1 (I), NOR3_2.P$1 (I0), NOR3_4.P$1 (I0), NOR3_6.P$1 (I0), NOR3_8.P$1 (I0)
unnamed: INV_3.P$1 (I), NOR3_3.P$3 (I2), NOR3_4.P$3 (I2), NOR3_7.P$3 (I2), NOR3_8.P$3 (I2)
unnamed: NAND2_3.P$2 (I1), NAND2_4.P$2 (I1), NAND2_5.P$2 (I1), NAND2_6.P$2 (I1), NAND2_7.P$2 (I1), NAND2_8.P$2 (I1), NAND2_9.P$2 (I1), NAND2_10.P$2 (I1), NOR2_1.P$3 (O)
unnamed: NAND2_2.P$1 (A), NAND2_5.P$1 (A)
unnamed: NAND2_1.P$1 (A), NAND2_7.P$1 (A)
unnamed: AND2_1.P$1 (A), NAND2_1.P$3 (O)
unnamed: NAND2_1.P$2 (I1), NAND2_2.P$2 (I1)

Notes on the sheet:
OpCode[4]
OpCode[3]
OpCode[2]
OpCode[1]
OpCode[0]
ZeroA
ShSign
AND
NOT
XOR
NAND
NOR
LLI
ShB
ASign
ShInBit
