rohitrayana123/VLSI/eagle/ALU/ALUDecoderMore1v2.sch

## EAGLE design eagle/ALU/ALUDecoderMore1v2.sch (2014-05-12)

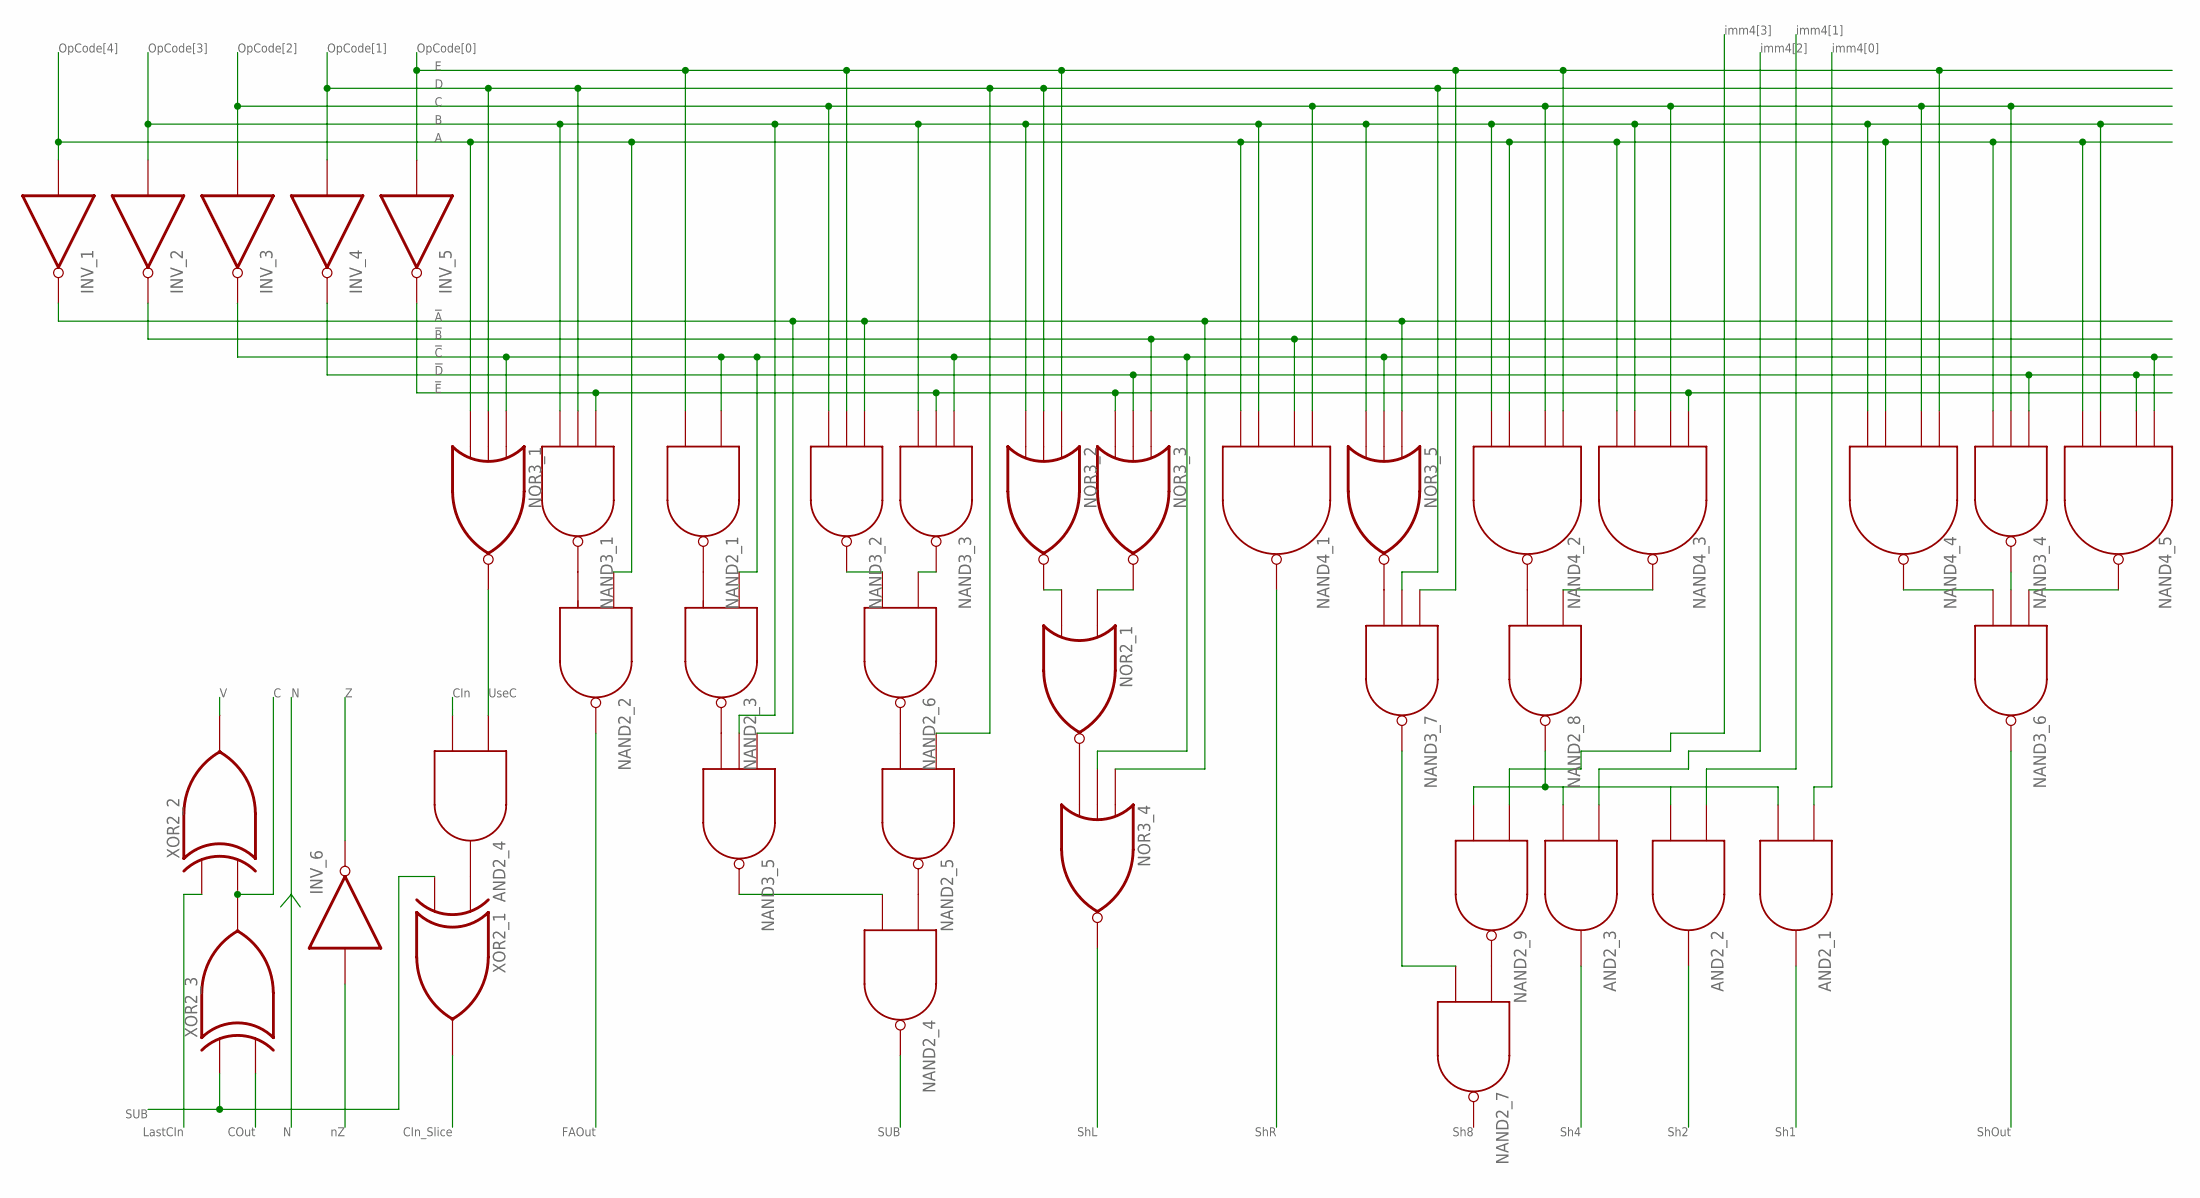
[picture p64: schematic ALUDecoderMore1v2.sch]

Parts:
AND2_1, AND2_2, AND2_3, AND2_4: AND2; 3PIN
INV_1, INV_2, INV_3, INV_4, INV_5, INV_6: INV; 3PIN
NAND2_1, NAND2_2, NAND2_3, NAND2_4, NAND2_5, NAND2_6, NAND2_7, NAND2_8, NAND2_9: NAND2; 3PIN
NAND3_1, NAND3_2, NAND3_3, NAND3_4, NAND3_5, NAND3_6, NAND3_7: NAND3; 5PIN
NAND4_1, NAND4_2, NAND4_3, NAND4_4, NAND4_5: NAND4; 5PIN
NOR2_1: NOR2; 3PIN
NOR3_1, NOR3_2, NOR3_3, NOR3_4, NOR3_5: NOR3; 5PIN
XOR2_1, XOR2_2, XOR2_3: XOR2; 3PIN

Connections:
unnamed: NAND2_1.P$3 (O), NAND2_3.P$2 (I1)
unnamed: NAND2_2.P$2 (I1), NAND3_1.P$4 (O)
unnamed: NAND2_3.P$3 (O), NAND3_5.P$2 (I1)
unnamed: NAND2_6.P$2 (I1), NAND3_2.P$4 (O)
unnamed: NAND2_6.P$1 (A), NAND3_3.P$4 (O)
unnamed: NOR2_1.P$1 (I0), NOR3_3.P$4 (O)
unnamed: NOR2_1.P$2 (I1), NOR3_2.P$4 (O)
unnamed: NOR2_1.P$3 (O), NOR3_4.P$2 (I1)
unnamed: NAND2_8.P$2 (I1), NAND4_2.P$5 (O)
unnamed: NAND2_8.P$1 (A), NAND4_3.P$5 (O)
unnamed: NAND2_4.P$1 (A), NAND2_5.P$3 (O)
unnamed: AND2_1.P$2 (I1), AND2_2.P$2 (I1), AND2_3.P$2 (I1), NAND2_8.P$3 (O), NAND2_9.P$2 (I1)
unnamed: NAND3_6.P$2 (I1), NAND4_4.P$5 (O)
unnamed: NAND3_4.P$4 (O), NAND3_6.P$3 (I2)
unnamed: NAND3_6.P$1 (A), NAND4_5.P$5 (O)
unnamed: NAND3_7.P$2 (I1), NOR3_5.P$4 (O)
unnamed: XOR2_2.P$2 (I1), XOR2_3.P$3 (O)
unnamed: NAND2_7.P$2 (I1), NAND3_7.P$4 (O)
unnamed: AND2_4.P$1 (A), NOR3_1.P$4 (O)
unnamed: AND2_4.P$3 (O), XOR2_1.P$1 (I0)
unnamed: XOR2_1.P$2 (I1), XOR2_3.P$1 (I0)
unnamed: INV_3.P$2 (O), INV_4.P$2 (O), INV_5.P$2 (O), NAND2_1.P$1 (A), NAND2_3.P$1 (A), NAND3_1.P$1 (A), NAND3_3.P$1 (A), NAND3_3.P$3 (I2), NAND3_4.P$1 (A), NAND4_3.P$1 (A), NAND4_5.P$1 (A), NAND4_5.P$2 (A1), NOR3_1.P$1 (I0), NOR3_3.P$2 (I1), NOR3_3.P$3 (I2), NOR3_4.P$3 (I2), NOR3_5.P$3 (I2)
unnamed: NAND2_4.P$2 (I1), NAND3_5.P$4 (O)
unnamed: NAND2_5.P$2 (I1), NAND2_6.P$3 (O)
unnamed: NAND2_7.P$1 (A), NAND2_9.P$3 (O)
unnamed: INV_1.P$2 (O), NAND3_2.P$1 (A), NAND3_5.P$1 (A), NOR3_4.P$1 (I0), NOR3_5.P$1 (I0)
unnamed: INV_2.P$2 (O), NAND4_1.P$2 (A1), NOR3_3.P$1 (I0)
unnamed: INV_1.P$1 (I), NAND2_1.P$2 (I1), NAND2_2.P$1 (A), NAND2_5.P$1 (A), NAND3_1.P$2 (I1), NAND3_1.P$3 (I2), NAND3_2.P$2 (I1), NAND3_2.P$3 (I2), NAND3_3.P$2 (I1), NAND3_4.P$2 (I1), NAND3_4.P$3 (I2), NAND3_5.P$3 (I2), NAND3_7.P$1 (A), NAND3_7.P$3 (I2), NAND4_1.P$3 (I1), NAND4_1.P$4 (I2), NAND4_2.P$1 (A), NAND4_2.P$2 (A1), NAND4_2.P$3 (I1), NAND4_2.P$4 (I2), NAND4_3.P$2 (A1), NAND4_3.P$3 (I1), NAND4_3.P$4 (I2), NAND4_4.P$1 (A), NAND4_4.P$2 (A1), NAND4_4.P$3 (I1), NAND4_4.P$4 (I2), NAND4_5.P$3 (I1), NAND4_5.P$4 (I2), NOR3_1.P$2 (I1), NOR3_1.P$3 (I2), NOR3_2.P$1 (I0), NOR3_2.P$2 (I1), NOR3_2.P$3 (I2), NOR3_5.P$2 (I1)

Notes on the sheet:
FAOut
OpCode[0]
OpCode[1]
OpCode[2]
OpCode[3]
OpCode[4]
SUB
ShL
Sh8
Sh4
Sh2
Sh1
imm4[0]
imm4[1]
imm4[2]
imm4[3]
ShOut
UseC
ShR
CIn
CIn_Slice
COut
LastCIn
