rohitrayana123/VLSI/eagle/ALU/ArithLogicSlice.sch

## EAGLE design eagle/ALU/ArithLogicSlice.sch (2014-05-11)

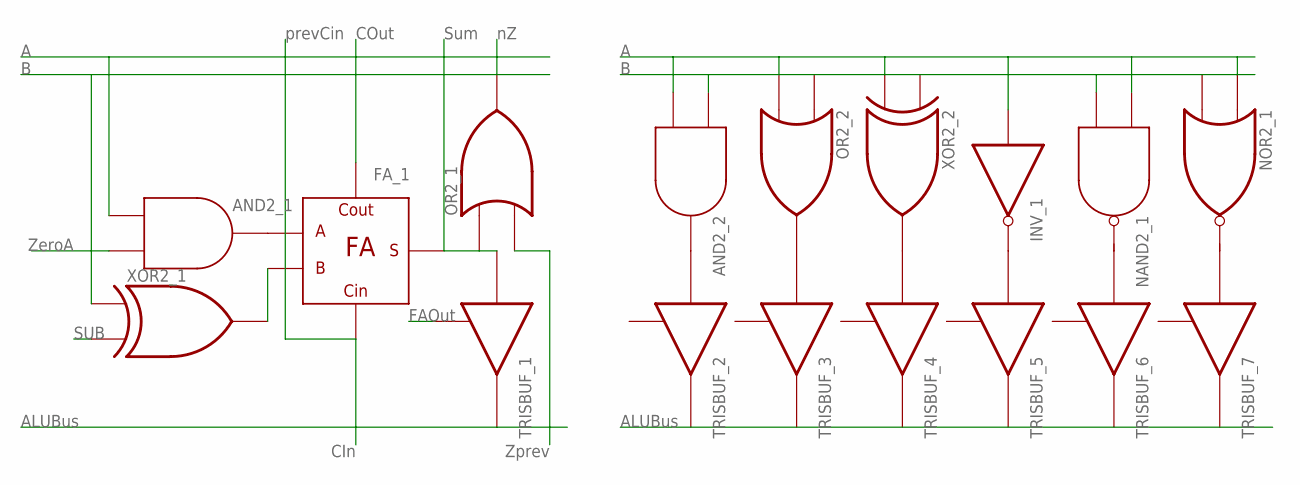
[picture p65: schematic ArithLogicSlice.sch]

Parts:
AND2_1, AND2_2: AND2; 3PIN
FA_1: FULLADDER; 5PIN
INV_1: INV; 3PIN
NAND2_1: NAND2; 3PIN
NOR2_1: NOR2; 3PIN
OR2_1, OR2_2: OR2; 3PIN
TRISBUF_1, TRISBUF_2, TRISBUF_3, TRISBUF_4, TRISBUF_5, TRISBUF_6, TRISBUF_7: TRISBUF; 3PIN
XOR2_1, XOR2_2: XOR2; 3PIN

Connections:
unnamed: AND2_2.P$3 (O), TRISBUF_2.P$1 (I)
unnamed: OR2_2.P$3 (O), TRISBUF_3.P$1 (I)
unnamed: TRISBUF_4.P$1 (I), XOR2_2.P$3 (O)
unnamed: INV_1.P$2 (O), TRISBUF_5.P$1 (I)
unnamed: NAND2_1.P$3 (O), TRISBUF_6.P$1 (I)
unnamed: NOR2_1.P$3 (O), TRISBUF_7.P$1 (I)
unnamed: AND2_2.P$1 (A), AND2_2.P$2 (I1), INV_1.P$1 (I), NAND2_1.P$1 (A), NAND2_1.P$2 (I1), OR2_2.P$2 (I1), XOR2_2.P$2 (I1)
unnamed: AND2_1.P$3 (O), FA_1.P$1 (A)
unnamed: FA_1.P$2 (B), XOR2_1.P$3 (O)
unnamed: FA_1.P$5 (S), OR2_1.P$1 (I0), TRISBUF_1.P$1 (I)

Notes on the sheet:
ALUBus
SUB
ZeroA
COut
CIn
Zprev
Sum
prevCin
FAOut
