rohitrayana123/VLSI/eagle/ALU/ArithSlice.sch

## EAGLE design eagle/ALU/ArithSlice.sch (2014-05-12)

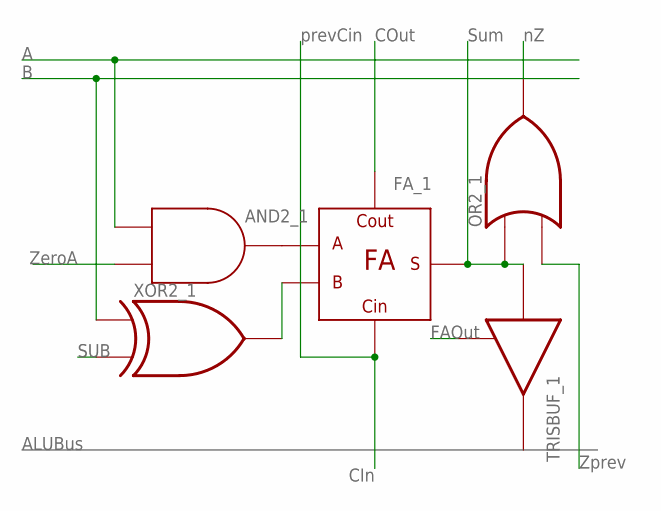
[picture p66: schematic ArithSlice.sch]

Parts:
AND2_1: AND2; 3PIN
FA_1: FULLADDER; 5PIN
OR2_1: OR2; 3PIN
TRISBUF_1: TRISBUF; 3PIN
XOR2_1: XOR2; 3PIN

Connections:
unnamed: AND2_1.P$3 (O), FA_1.P$1 (A)
unnamed: FA_1.P$2 (B), XOR2_1.P$3 (O)
unnamed: FA_1.P$5 (S), OR2_1.P$1 (I0), TRISBUF_1.P$1 (I)

Notes on the sheet:
ALUBus
SUB
ZeroA
COut
CIn
Zprev
Sum
prevCin
FAOut
