rohitrayana123/VLSI/eagle/ALU/ShiftSlice.sch

## EAGLE design eagle/ALU/ShiftSlice.sch (2014-05-12)

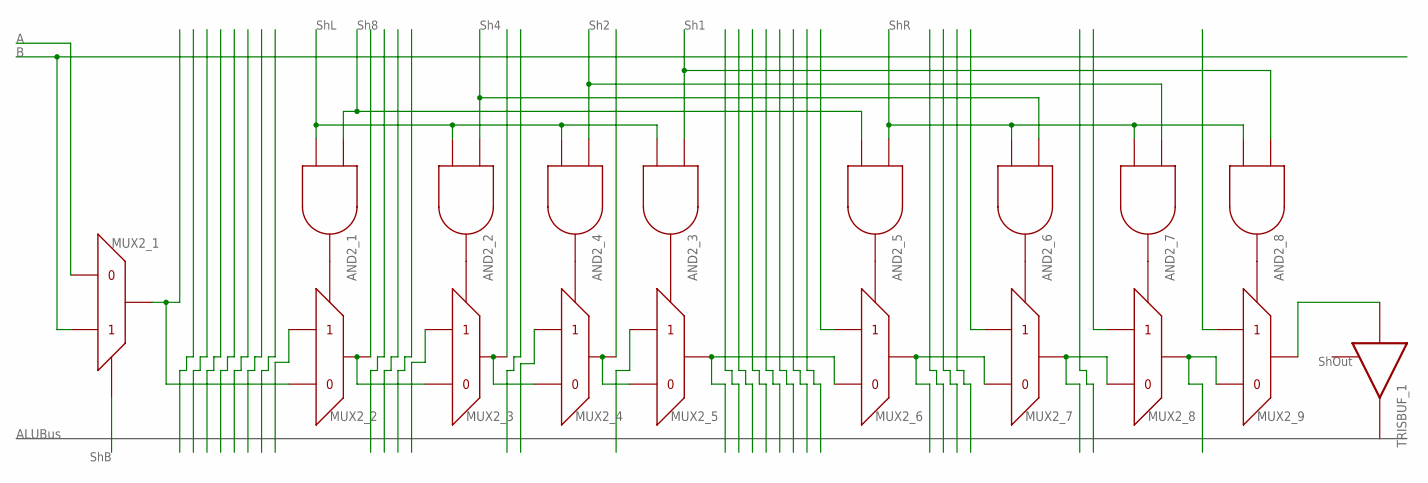
[picture p68: schematic ShiftSlice.sch]

Parts:
AND2_1, AND2_2, AND2_3, AND2_4, AND2_5, AND2_6, AND2_7, AND2_8: AND2; 3PIN
MUX2_1, MUX2_2, MUX2_3, MUX2_4, MUX2_5, MUX2_6, MUX2_7, MUX2_8, MUX2_9: MUX2; 5PIN
TRISBUF_1: TRISBUF; 3PIN

Connections:
unnamed: AND2_1.P$2 (I1), AND2_2.P$2 (I1), AND2_3.P$2 (I1), AND2_4.P$2 (I1)
unnamed: AND2_5.P$1 (A), AND2_6.P$2 (I1), AND2_7.P$2 (I1), AND2_8.P$2 (I1)
unnamed: MUX2_6.P$3, MUX2_7.P$1
unnamed: MUX2_7.P$3, MUX2_8.P$1
unnamed: MUX2_8.P$3, MUX2_9.P$1
unnamed: MUX2_1.P$3, MUX2_2.P$1
unnamed: AND2_1.P$1 (A), AND2_5.P$2 (I1)
unnamed: AND2_2.P$1 (A), AND2_6.P$1 (A)
unnamed: AND2_4.P$1 (A), AND2_7.P$1 (A)
unnamed: AND2_3.P$1 (A), AND2_8.P$1 (A)
unnamed: MUX2_9.P$3, TRISBUF_1.P$1 (I)
unnamed: AND2_1.P$3 (O), MUX2_2.P$4
unnamed: AND2_2.P$3 (O), MUX2_3.P$4
unnamed: AND2_4.P$3 (O), MUX2_4.P$4
unnamed: AND2_3.P$3 (O), MUX2_5.P$4
unnamed: AND2_5.P$3 (O), MUX2_6.P$4
unnamed: AND2_6.P$3 (O), MUX2_7.P$4
unnamed: AND2_7.P$3 (O), MUX2_8.P$4
unnamed: AND2_8.P$3 (O), MUX2_9.P$4
unnamed: MUX2_5.P$3, MUX2_6.P$1

Notes on the sheet:
ALUBus
ShL
ShR
Sh8
Sh4
Sh2
Sh1
ShB
ShOut
