rohitrayana123/VLSI/eagle/Interrupt/ControlIF.sch

## EAGLE design eagle/Interrupt/ControlIF.sch (2014-05-12)

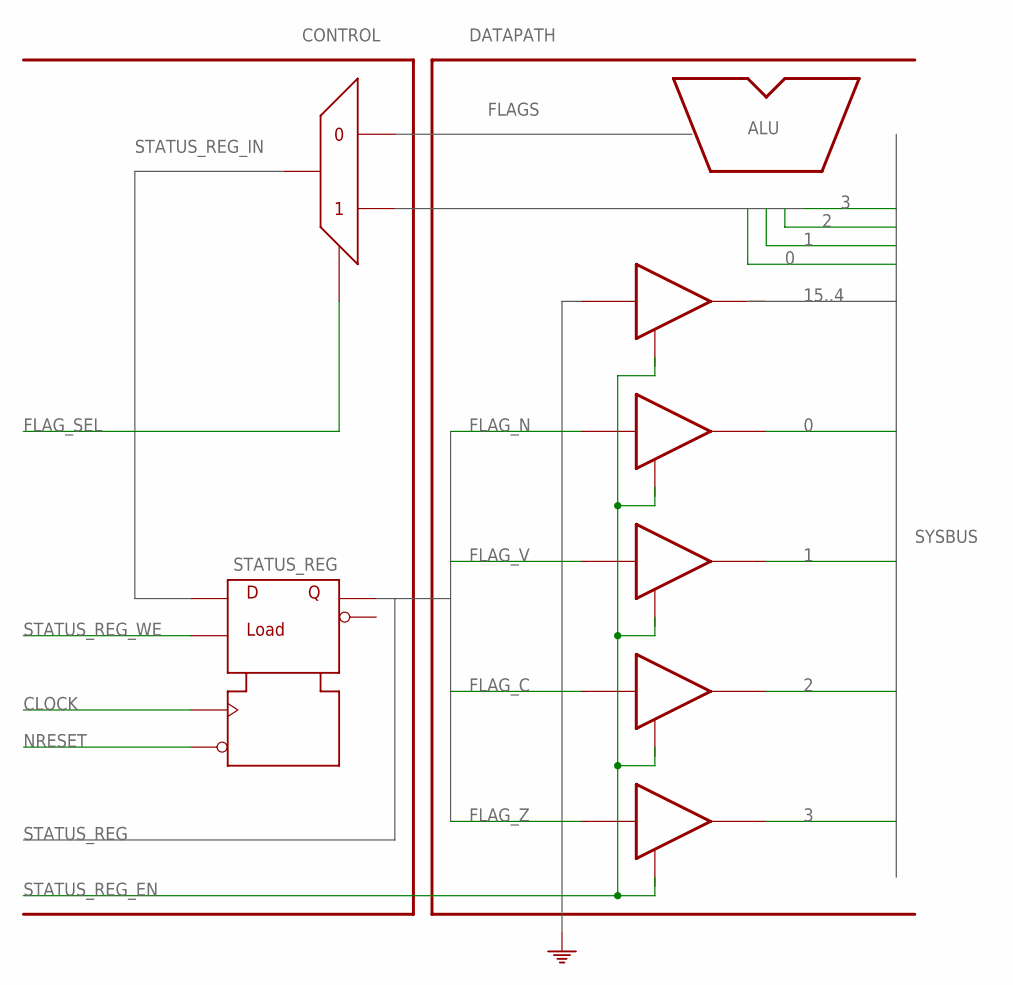
[picture p69: schematic ControlIF.sch]

Parts:
MUX2_1: MUX2; 5PIN
STATUS_REG: SCANREG; 6PIN
TRISBUF_1, TRISBUF_2, TRISBUF_3, TRISBUF_4, TRISBUF_5: TRISBUF; 3PIN

Connections:
0: TRISBUF_4.P$2 (O)
1: TRISBUF_3.P$2 (O)
2: TRISBUF_2.P$2 (O)
3: TRISBUF_1.P$2 (O)
CLOCK: STATUS_REG.P$1 (CLOCK)
FLAG_C: TRISBUF_2.P$1 (I)
FLAG_SEL: MUX2_1.P$4
FLAG_Z: TRISBUF_1.P$1 (I)
NRESET: STATUS_REG.P$5 (NRESET)
STATUS_REG_WE: STATUS_REG.P$3 (LOAD)

Notes on the sheet:
CONTROL
ALU
DATAPATH
