rohitrayana123/VLSI/eagle/Interrupt/Interrupt.sch

## EAGLE design eagle/Interrupt/Interrupt.sch (2014-05-09)

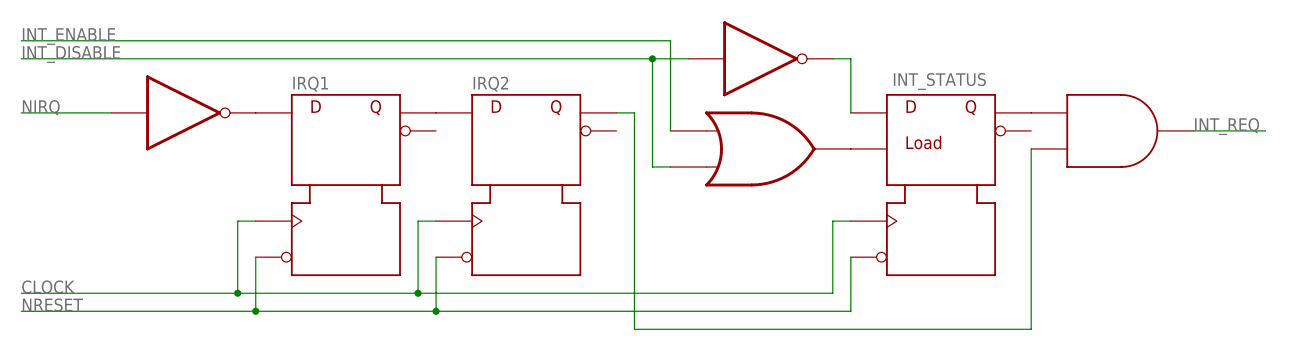
[picture p70: schematic Interrupt.sch]

Parts:
AND2_1: AND2; 3PIN
INT_STATUS: SCANREG; 6PIN
INV_1, INV_2: INV; 3PIN
IRQ1, IRQ2: SCANDTYPE; 5PIN
OR2_1: OR2; 3PIN

Connections:
CLOCK: INT_STATUS.P$1 (CLOCK), IRQ1.P$1 (CLOCK), IRQ2.P$1 (CLOCK)
INT_DISABLE: INV_2.P$1 (I), OR2_1.P$2 (I1)
INT_ENABLE: OR2_1.P$1 (I0)
INT_REQ: AND2_1.P$3 (O)
IRQ2: AND2_1.P$2 (I1), IRQ2.P$5 (Q)
unnamed: IRQ1.P$5 (Q), IRQ2.P$2 (D)
unnamed: INV_1.P$2 (O), IRQ1.P$2 (D)
unnamed: INT_STATUS.P$3 (LOAD), OR2_1.P$3 (O)
unnamed: AND2_1.P$1 (A), INT_STATUS.P$6 (Q)
unnamed: INT_STATUS.P$2 (D), INV_2.P$2 (O)
NIRQ: INV_1.P$1 (I)
NRESET: INT_STATUS.P$5 (NRESET), IRQ1.P$4 (NRESET), IRQ2.P$4 (NRESET)
