rohitrayana123/VLSI/eagle/Ir/IrAA.sch

## EAGLE design eagle/Ir/IrAA.sch (2014-05-03)

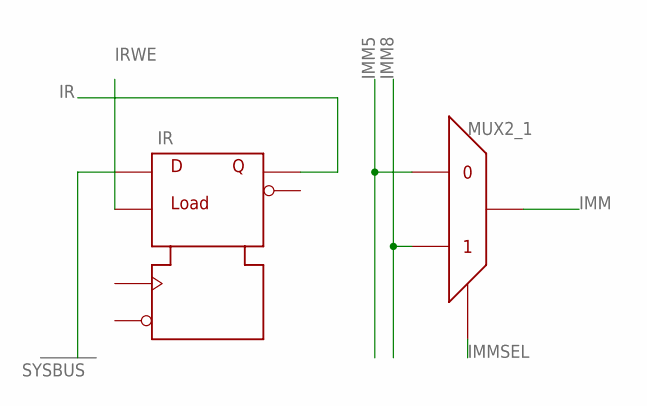
[picture p71: schematic IrAA.sch]

Parts:
IR: SCANREG; 6PIN
MUX2_1: MUX2; 5PIN

Connections:
IMM: MUX2_1.P$3
IMM5: MUX2_1.P$1
IMM8: MUX2_1.P$2
IMMSEL: MUX2_1.P$4
IR: IR.P$6 (Q)
IRWE: IR.P$3 (LOAD)
