rohitrayana123/VLSI/eagle/PcBlock/PcBlock_Slice.sch

## EAGLE design eagle/PcBlock/PcBlock_Slice.sch (2014-05-04)

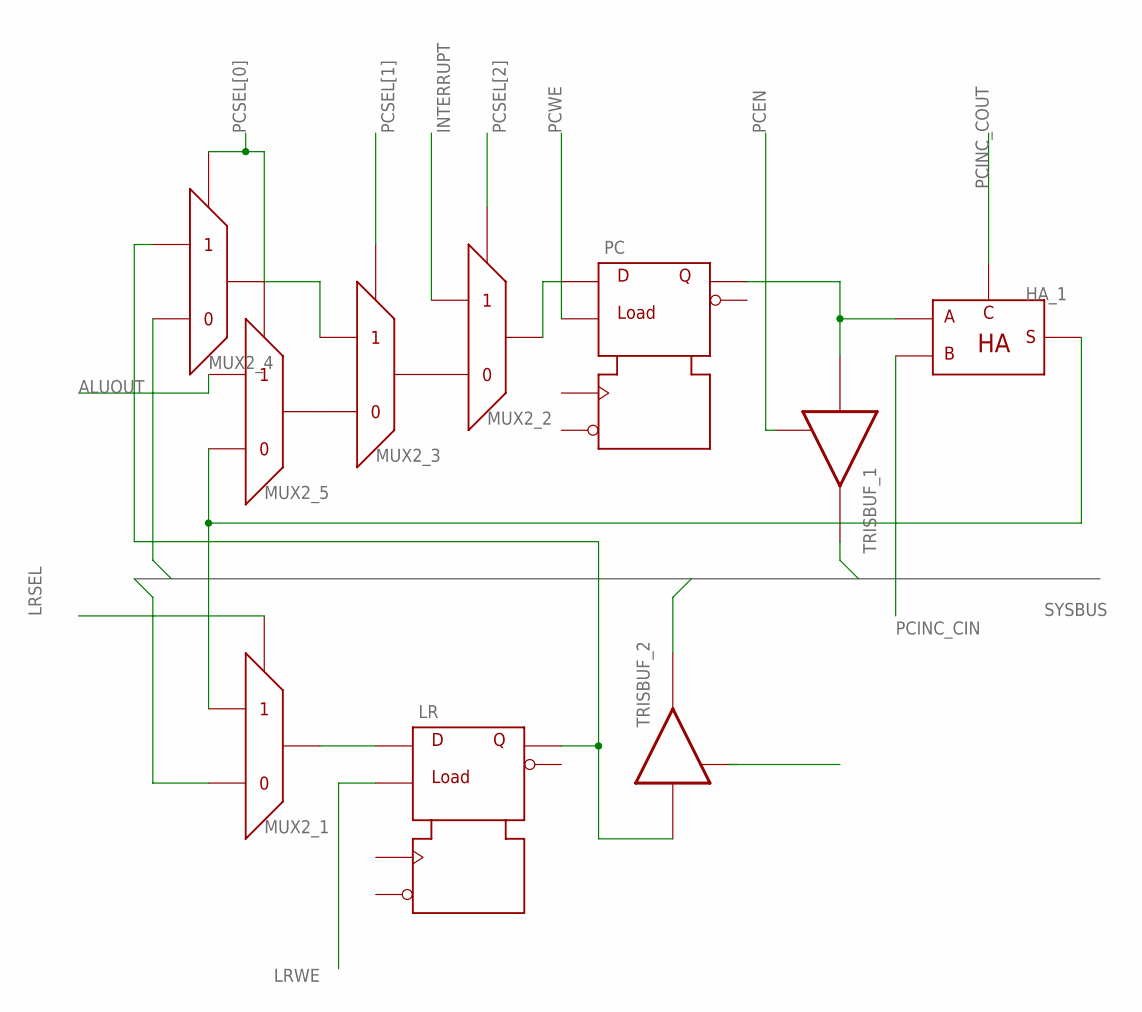
[picture p72: schematic PcBlock_Slice.sch]

Parts:
HA_1: HALFADDER; 5PIN
LR: SCANREG; 6PIN
MUX2_1, MUX2_2, MUX2_3, MUX2_4, MUX2_5: MUX2; 5PIN
PC: SCANREG; 6PIN
TRISBUF_1, TRISBUF_2: TRISBUF; 3PIN

Connections:
ALUOUT: MUX2_5.P$2
INTERRUPT: MUX2_2.P$2
LRSEL: MUX2_1.P$4
LRWE: LR.P$3 (LOAD)
unnamed: HA_1.P$1 (A), PC.P$6 (Q), TRISBUF_1.P$1 (I)
unnamed: LR.P$2 (D), MUX2_1.P$3
unnamed: MUX2_2.P$3, PC.P$2 (D)
unnamed: MUX2_3.P$1, MUX2_5.P$3
unnamed: MUX2_3.P$2, MUX2_4.P$3
unnamed: HA_1.P$4 (S), MUX2_1.P$2, MUX2_5.P$1
unnamed: MUX2_2.P$1, MUX2_3.P$3
unnamed: LR.P$6 (Q), MUX2_4.P$2, TRISBUF_2.P$1 (I)
PCEN: TRISBUF_1.P$3
PCINC_CIN: HA_1.P$2 (B)
PCINC_COUT: HA_1.P$3 (COUT)
PCSEL[0]: MUX2_4.P$4, MUX2_5.P$4
PCSEL[1]: MUX2_3.P$4
PCSEL[2]: MUX2_2.P$4
PCWE: PC.P$3 (LOAD)
SYSBUS: MUX2_1.P$1, MUX2_4.P$1, TRISBUF_1.P$2 (O), TRISBUF_2.P$2 (O)
