rohitrayana123/VLSI/eagle/regBlock/decoder.sch

## EAGLE design eagle/regBlock/decoder.sch (2014-05-03)

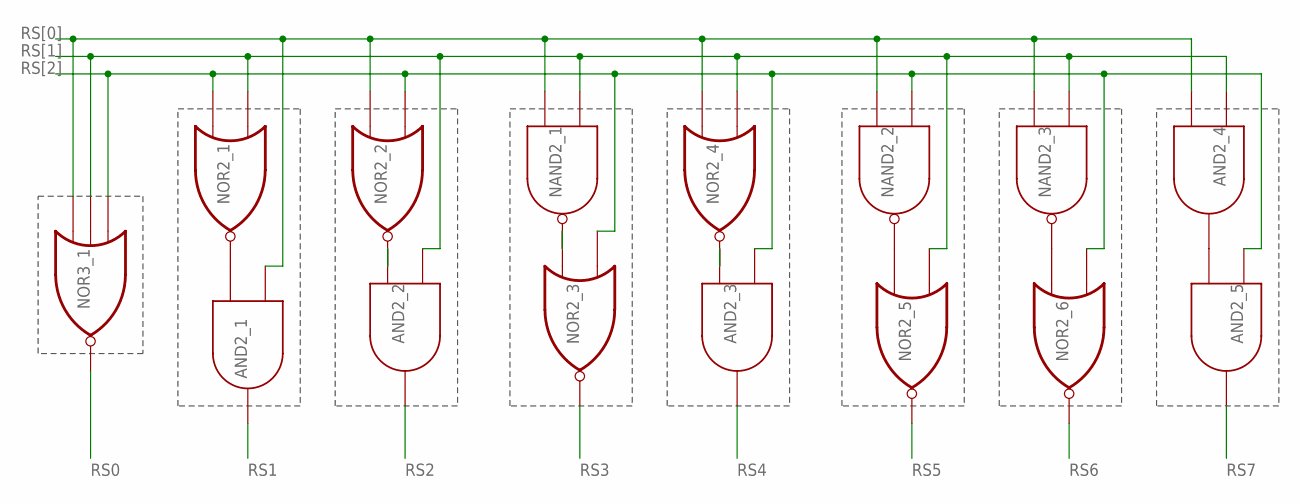
[picture p73: schematic decoder.sch]

Parts:
AND2_1, AND2_2, AND2_3, AND2_4, AND2_5: AND2; 3PIN
NAND2_1, NAND2_2, NAND2_3: NAND2; 3PIN
NOR2_1, NOR2_2, NOR2_3, NOR2_4, NOR2_5, NOR2_6: NOR2; 3PIN
NOR3_1: NOR3; 5PIN

Connections:
unnamed: AND2_1.P$2 (I1), NOR2_1.P$3 (O)
unnamed: AND2_2.P$2 (I1), NOR2_2.P$3 (O)
unnamed: NAND2_1.P$3 (O), NOR2_3.P$2 (I1)
unnamed: AND2_3.P$2 (I1), NOR2_4.P$3 (O)
unnamed: NAND2_2.P$3 (O), NOR2_5.P$2 (I1)
unnamed: NAND2_3.P$3 (O), NOR2_6.P$2 (I1)
unnamed: AND2_4.P$3 (O), AND2_5.P$2 (I1)
RS0: NOR3_1.P$4 (O)
RS1: AND2_1.P$3 (O)
RS2: AND2_2.P$3 (O)
RS3: NOR2_3.P$3 (O)
RS4: AND2_3.P$3 (O)
RS5: NOR2_5.P$3 (O)
RS6: NOR2_6.P$3 (O)
RS7: AND2_5.P$3 (O)
RS[0]: AND2_1.P$1 (A), AND2_4.P$2 (I1), NAND2_1.P$2 (I1), NAND2_2.P$2 (I1), NAND2_3.P$2 (I1), NOR2_2.P$2 (I1), NOR2_4.P$2 (I1), NOR3_1.P$2 (I1)
RS[1]: AND2_2.P$1 (A), AND2_4.P$1 (A), NAND2_1.P$1 (A), NAND2_3.P$1 (A), NOR2_1.P$1 (I0), NOR2_4.P$1 (I0), NOR2_5.P$1 (I0), NOR3_1.P$3 (I2)
RS[2]: AND2_3.P$1 (A), AND2_5.P$1 (A), NAND2_2.P$1 (A), NOR2_1.P$2 (I1), NOR2_2.P$1 (I0), NOR2_3.P$1 (I0), NOR2_6.P$1 (I0), NOR3_1.P$1 (I0)
