rohitrayana123/VLSI/eagle/regBlock/regBlock_slice.sch

## EAGLE design eagle/regBlock/regBlock_slice.sch (2014-05-03)

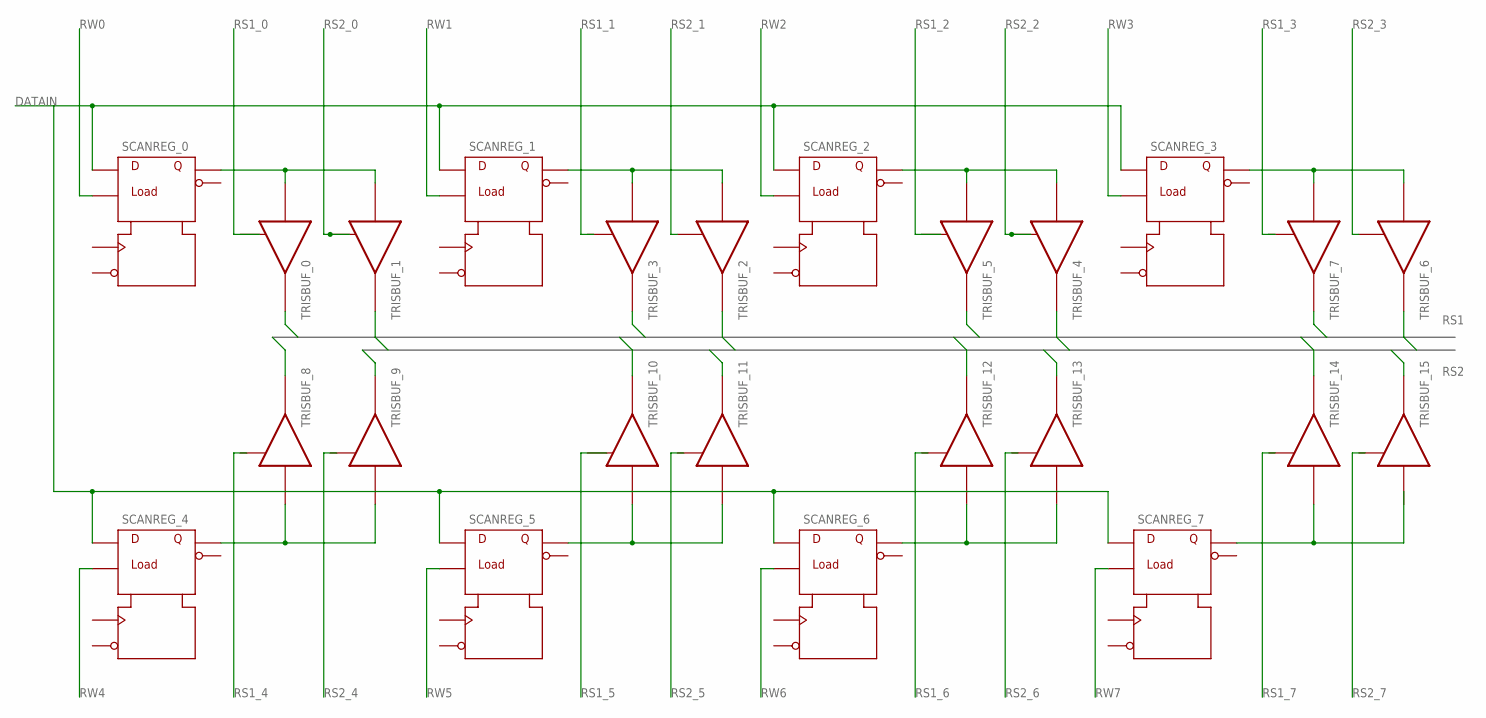
[picture p74: schematic regBlock_slice.sch]

Parts:
SCANREG_0, SCANREG_1, SCANREG_2, SCANREG_3, SCANREG_4, SCANREG_5, SCANREG_6, SCANREG_7: SCANREG; 6PIN
TRISBUF_0, TRISBUF_1, TRISBUF_2, TRISBUF_3, TRISBUF_4, TRISBUF_5, TRISBUF_6, TRISBUF_7, TRISBUF_8, TRISBUF_9, TRISBUF_10, TRISBUF_11, TRISBUF_12, TRISBUF_13, TRISBUF_14, TRISBUF_15: TRISBUF; 3PIN

Connections:
B$1: TRISBUF_0.P$2 (O), TRISBUF_3.P$2 (O), TRISBUF_5.P$2 (O), TRISBUF_7.P$2 (O), TRISBUF_8.P$2 (O), TRISBUF_10.P$2 (O), TRISBUF_12.P$2 (O), TRISBUF_14.P$2 (O)
B$2: TRISBUF_1.P$2 (O), TRISBUF_2.P$2 (O), TRISBUF_4.P$2 (O), TRISBUF_6.P$2 (O), TRISBUF_9.P$2 (O), TRISBUF_11.P$2 (O), TRISBUF_13.P$2 (O), TRISBUF_15.P$2 (O)
DATAIN: SCANREG_0.P$2 (D), SCANREG_1.P$2 (D), SCANREG_2.P$2 (D), SCANREG_3.P$2 (D), SCANREG_4.P$2 (D), SCANREG_5.P$2 (D), SCANREG_6.P$2 (D), SCANREG_7.P$2 (D)
unnamed: SCANREG_0.P$6 (Q), TRISBUF_0.P$1 (I), TRISBUF_1.P$1 (I)
unnamed: SCANREG_1.P$6 (Q), TRISBUF_2.P$1 (I), TRISBUF_3.P$1 (I)
unnamed: SCANREG_2.P$6 (Q), TRISBUF_4.P$1 (I), TRISBUF_5.P$1 (I)
unnamed: SCANREG_3.P$6 (Q), TRISBUF_6.P$1 (I), TRISBUF_7.P$1 (I)
unnamed: SCANREG_4.P$6 (Q), TRISBUF_8.P$1 (I), TRISBUF_9.P$1 (I)
unnamed: SCANREG_5.P$6 (Q), TRISBUF_10.P$1 (I), TRISBUF_11.P$1 (I)
unnamed: SCANREG_6.P$6 (Q), TRISBUF_12.P$1 (I), TRISBUF_13.P$1 (I)
unnamed: SCANREG_7.P$6 (Q), TRISBUF_14.P$1 (I)
RS2_0: TRISBUF_1.P$3
RS2_1: TRISBUF_2.P$3
RS2_2: TRISBUF_4.P$3
RS2_3: TRISBUF_6.P$3
RW0: SCANREG_0.P$3 (LOAD)
RW1: SCANREG_1.P$3 (LOAD)
RW2: SCANREG_2.P$3 (LOAD)
RW3: SCANREG_3.P$3 (LOAD)
RW4: SCANREG_4.P$3 (LOAD)
RW5: SCANREG_5.P$3 (LOAD)
RW6: SCANREG_6.P$3 (LOAD)
RW7: SCANREG_7.P$3 (LOAD)
