rohitrayana123/VLSI/Design/Implementation/programs/fullCoverage.asm

		ADDIB R0,#0
		ADDIB R0,#0
		ADDIB R0,#0
		ADDIB R0,#0
		ADDIB R0,#0
		ADDIB R0,#0
		ADDIB R0,#0
		ADDIB R0,#0
		ADDIB R0,#0
		ADDIB R0,#0
		ADDIB R0,#0
		ADDIB R0,#0
		ADDIB R0,#0
		ADDIB R0,#0
		ADDIB R0,#0
		ADDIB R0,#0
		BR .add			
		LUI R0, #255	; PASS - LINE 1 - 0xFFFF is pass code
		BR .leds
		LUI R0, #0		; FAIL - LINE 3 -  0x00FF is fail code
.leds	LLI R0, #255
		LUI R1, #8		; Address of leds
		LLI R1, #1
		STW R0,[R1,#0]	; Status on LEDS
.end	BR .end			; Terminate loop	
.add	LUI R0,	#0		
		LLI R0,	#1
		ADD R7,R0,R0	; R0
		ADD R6,R0,R0			
		ADD R5,R0,R0
		ADD R4,R0,R0
		ADD R3,R0,R0
		ADD R2,R0,R0
		ADD R1,R0,R0
		ADD R0,R0,R0	; 0x0002 in all regsisters
		ADD R7,R1,R1 	; R1
		ADD R6,R1,R1			
		ADD R5,R1,R1
		ADD R4,R1,R1
		ADD R3,R1,R1
		ADD R2,R1,R1
		ADD R0,R1,R1
		ADD R1,R1,R1	; 0x0004 in all regsisters
		ADD R7,R2,R2	; R2 
		ADD R6,R2,R2			
		ADD R5,R2,R2
		ADD R4,R2,R2
		ADD R3,R2,R2
		ADD R3,R2,R2
		ADD R0,R2,R2
		ADD R2,R2,R2	; 0x0008 in all regsisters
		ADD R7,R3,R3	; R3 
		ADD R6,R3,R3			
		ADD R5,R3,R3
		ADD R4,R3,R3
		ADD R2,R3,R3
		ADD R1,R3,R3
		ADD R0,R3,R3
		ADD R3,R3,R3	; 0x0010 in all regsisters
		ADD R7,R4,R4	; R4 
		ADD R6,R4,R4			
		ADD R5,R4,R4
		ADD R3,R4,R4
		ADD R2,R4,R4
		ADD R1,R4,R4
		ADD R0,R4,R4
		ADD R4,R4,R4	; 0x0020 in all regsisters
		ADD R7,R5,R5	; R5 
		ADD R6,R5,R5			
		ADD R4,R5,R5
		ADD R3,R5,R5	
		ADD R2,R5,R5
		ADD R1,R5,R5
		ADD R0,R5,R5
		ADD R5,R5,R5	; 0x0040 in all regsisters
		ADD R7,R6,R6 	; R6
		ADD R5,R6,R6			
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
		LLI R0,#170
		LSR R0,R0,#7
		LUI R1,#1
		LLI R1,#85
		CMP R0,R1
		BNE .Flsr
		LUI R0,#170
		LLI R0,#170
		LSR R0,R0,#8
		LUI R1,#0
		LLI R1,#170
		CMP R0,R1
		BNE .Flsr
		LUI R0,#170
		LLI R0,#170
		LSR R0,R0,#9
		LUI R1,#0
		LLI R1,#85
		CMP R0,R1
		BNE .Flsr
		LUI R0,#170
		LLI R0,#170
		LSR R0,R0,#10
		LUI R1,#0
		LLI R1,#42
		CMP R0,R1
		BNE .Flsr
		LUI R0,#170
		LLI R0,#170
		LSR R0,R0,#11
		LUI R1,#0
		LLI R1,#21
		CMP R0,R1
		BNE .Flsr
		LUI R0,#170
		LLI R0,#170
		LSR R0,R0,#12
		LUI R1,#0
		LLI R1,#10
		CMP R0,R1
		BNE .Flsr
		LUI R0,#170
		LLI R0,#170
		LSR R0,R0,#13
		LUI R1,#0
		LLI R1,#5
		CMP R0,R1
		BNE .Flsr
		LUI R0,#170
		LLI R0,#170
		LSR R0,R0,#14
		LUI R1,#0
		LLI R1,#2
		CMP R0,R1
		BNE .Flsr
		LUI R0,#170
		LLI R0,#170
		LSR R0,R0,#15
		LUI R1,#0
		LLI R1,#1
		CMP R0,R1
		BE .blt
.Flsr	SUB R0,R0,R0
		ADDIB R0,#26
		JMP R0,#0
.blt	LUI R0,#255
		LLI R0,#255
		ADDI R1,R0,#0
		CMP R0,R1		; Make sure all regs are the same
		BR .bge
.Fblt	SUB R0,R0,R0
		ADDIB R0,#26
		JMP R0,#0
.bge	LUI R0,#255
		LLI R0,#255
		ADDI R1,R0,#0
		CMP R0,R1		; Make sure all regs are the same
		BE .pass
.Fbge	SUB R0,R0,R0
		ADDIB R0,#26
		JMP R0,#0
.pass	SUB R0,R0,R0
		ADDIB R0,#23
		JMP R0,#0
