rohitrayana123/VLSI/Design/Implementation/verilog/behavioural/cpu_core.sv

// Written by ajr2g10
module cpu_core(
  output wire  [15:0]   Data_out,
  output wire           nOE,
  output wire           nME,
  output wire           ALE,
  output wire           ENB, 
  output wire           SDO,
  input  wire  [15:0]   Data_in,
  input  wire           nIRQ, 
  input  wire           nWait,
  input  wire           Test, 
  input  wire           SDI, 
  input  wire           Clock, 
  input  wire           nReset,
  output wire 			RnW
);

timeunit 1ns; timeprecision 100ps;

//opcodes::alu_functions_t  AluOp;  
wire         Op1Sel;  
wire [1:0]       Op2Sel;  
wire        AluEn;  
wire        LrEn;  
wire        LrWe; 
wire        LrSel;
wire        PcWe;  
wire [2:0]  PcSel;  
wire        PcEn;  
wire        IrWe;
wire        WdSel;  
wire        ImmSel;  
wire        RegWe; 
wire        MemEn;
wire [1:0]  Rs1Sel, AluOR;
wire        CFlag;
wire [3:0]  Flags;
wire [7:0]  Opcode;  
wire        AluWe;
wire[1:0]	RwSel;
wire [15:0]	SysBus;
wire [3:0]	FlagsOut;
wire [3:0]	StatusReg;
wire 		StatusRegEn;
wire [15:0]	Ir;
wire FlagListen;
wire FlagSel;
assign Opcode = Ir[15:8];
assign Data_out = SysBus;
`ifndef mixed
	assign SDO = SDI; // No sim 
`endif
control control ( 
//   	.AluOp      (AluOp      ),    // Ouputs  
   	.Op2Sel     (Op2Sel     ), 
   	.Op1Sel     (Op1Sel     ),
   	.AluEn      (AluEn      ),
   	.LrEn       (LrEn       ),
   	.LrWe       (LrWe       ),
   	.LrSel      (LrSel      ),
   	.PcWe       (PcWe       ), 
   	.PcEn       (PcEn       ),
   	.IrWe       (IrWe       ),
   	.WdSel      (WdSel      ),
   	.ImmSel     (ImmSel     ),
   	.RegWe      (RegWe      ),
   	.PcSel      (PcSel      ),
   	.MemEn      (MemEn      ),
   	.nWE        (RnW        ),//HSL: RnW - Read not Write - the signal to memory
   	.nOE        (nOE        ),
   	.nME        (nME        ),
   	.ENB        (ENB        ),
   	.ALE        (ALE        ),
   	.Rs1Sel     (Rs1Sel     ),
   	.RwSel		(RwSel		),
   	.CFlag      (CFlag      ),
   	.Flags      (Flags      ),
   	.OpcodeCondIn(Opcode    ),    // Inputs
  	.nWait		(nWait		), 
   	.SysBus     (SysBus[3:0]   ),
   	.AluWe      (AluWe      ),
   	.AluOR		(AluOR     	),
   	.Clock      (Clock      ),
   	.nReset     (nReset     ),
	.nIRQ		(nIRQ		),
	.StatusReg	(StatusReg),
	.StatusRegEn	(StatusRegEn)
);

datapath datapath ( 
`ifdef mixed
   .DataOut     (SysBus   ),
`else
   .SysBus     	(SysBus   ),   // Output
`endif
   .Ir	  		(Ir			),
   .Flags      	(Flags      ),  
   .DataIn     	(Data_in    ),
   .PcSel      	(PcSel      ),
   .Op1Sel     	(Op1Sel     ),
   .Op2Sel     	(Op2Sel     ),
   .AluEn      	(AluEn      ),
   .LrEn       	(LrEn       ),
   .LrWe       	(LrWe       ),
   .LrSel      	(LrSel      ),
   .PcWe       	(PcWe       ),
   .PcEn       	(PcEn       ),
   .IrWe       	(IrWe       ),
   .WdSel      	(WdSel      ),
   .ImmSel     	(ImmSel     ),
   .RegWe      	(RegWe      ),
   .MemEn      	(MemEn      ),
   .Rs1Sel     	(Rs1Sel     ),
   .RwSel	(RwSel      ),
   .CFlag      	(CFlag      ),
   .AluWe      	(AluWe      ),
   .StatusReg	(StatusReg),
   .StatusRegEn	(StatusRegEn),
   .AluOR	(AluOR	    ),
`ifdef mixed
   	.Test       (1'b0       ),
   	.SDI		(SDI      	),
	.SDO 		(SDO		),
`endif
   	.Clock      (Clock      ),
   	.nReset     (nReset     )
);


endmodule
