rohitrayana123/VLSI/Design/Implementation/programs/factorial_full_map.asm

		LUI 	R7, #7
		LLI 	R7, #208
		LUI 	R0, #128	; Address in R0
		LLI 	R0, #1
.start	SUBIB	R0,#1
		LDW 	R1,[R0,#0]	; Read switches into R1	
		PUSH 	R1			; Pass para
		BWL 	.fact		; Run Subroutine
		POP 	R3			; Para overwritten with result		
		ADDIB 	R0,#1
		STW 	R3,[R0,#0]	; Result on LEDS
		BR 		.start		;  finish loop
.fact   PUSH 	R0
		PUSH 	R1
		PUSH 	LR
		LDW 	R1,[SP,#3]  ; Get para	
		ADDIB 	R1,#0
		BE 		.retOne     	; 0! = 1
		SUBI 	R0,R1,#1
		PUSH 	R0        	; Pass para
		BWL 	.fact		; The output remains on the stack
		PUSH 	R1			; Pass para
		SUBIB 	SP,#1		; Placeholder
		BWL 	.multi
		POP 	R1          ; Get res
		ADDIB 	SP,#2     	; pop x 2
		STW 	R1,[SP,#3]
		POP 	LR
		POP 	R1
		POP 	R0
		RET
.retOne ADDIB 	R1,#1    	; Avoid jump checking
		STW 	R1,[SP,#3]                                                                                                  
		POP 	LR                                                                                                          
		POP 	R1                                                                                                          
		POP 	R0                                                                                                          
		RET
.multi  PUSH 	R0
		PUSH 	R1
		PUSH 	R2
		PUSH 	R3
		PUSH 	R4
		PUSH 	R5
		PUSH 	R6
		LDW 	R0,[SP,#8]	; R0 - Multiplier
		LDW 	R1,[SP,#9]  ; R1 - Quotient                  	                                                                              	
		CMP 	R0,R1
		BLT 	.nSw		; Branch if M < Q
		ADDI 	R2,R1,#0	; Make M the smallest
		ADDI 	R1,R0,#0
		ADDI 	R0,R2,#0
.nSw	SUB 	R2,R2,R2    ; R2 - Accumulator                                                                                                	
		ADDI 	R3,R2,#1	; R3 - 0x0001		
		LUI 	R4,#128		; R4 - 0x8000
		LLI 	R4,#0
.mloop	AND 	R6,R0,R3	; R6 - Cmp var  	
		CMPI 	R6,#1
		BNE 	.nAcc
		SUB 	R3,R3,R3
		ADD 	R2,R2,R1	; A = A + Q	
		ADCI 	R3,R3,#1
		CMPI 	R3,#2 
		BE 		.fail		; OV
.nAcc	LSR 	R0,R0,#1	; M = M >> 1
		CMPI 	R0,#0
		BE 		.done
		AND 	R5,R4,R1
		CMPI 	R5,#0
		BNE 	.fail		
		LSL 	R1,R1,#1	; Q = Q << 1
		BR 		.mloop
.done	STW 	R2,[SP,#7]	; Res on stack frame                                                                                         
		POP 	R6
		POP 	R5
		POP 	R4
		POP 	R3
		POP 	R2
		POP 	R1
		POP 	R0
		RET
.fail	SUB 	R2,R2,R2	; OV - ret 0
		BR 		.done
	
