rohitrayana123/VLSI/(commit log)

2014-02-04 Sample asm code
2014-02-12 Added a data path idea
    Currently, has no instruction parts listed going to the places.
    I think it should support most of the Thumb instructions.
    @ashleyjr could you have a ganders at this before tomorrow? In the short amount of time I have, we'll go through all our ideas.
    Apologies it's not pretty like yours.
2014-02-12 Completed ARM section.
    Started on 8086. Needs finishing.
2014-02-15 Removed the stuff about ARM conditional execution
    I am pressing the word limit as is. I've taken this out to save space.
    IDEA: maybe put it in an appendix?
2014-02-16 Completed Instruction Set Summary for Approval
    [Summary.xlsx]
2014-02-17 Renamed folder.
    Please be careful with spaces in folder names - Linux doesn't cope too well with it!
    [Summary.xlsx]
2014-02-17 Some ammendments done.
    Write data now wired up.
    Matched the proposed instruction set
2014-02-17 ISv2 @seblovett @ashleyjr @arr1g13
    [Summary.xlsx]
2014-02-17 Fixed to work with new version
    [regBlock_stim.sv]
2014-02-17 Added a reset to the registers.
    Will reset all regs to 0
    [regBlock.sv, regBlock_stim.sv]
2014-02-18 Made more flexible
    Will list all stim files in help.
    Use the given module as the top level (with _stim.sv on the end).
    Use the current dir as the library.
2014-02-18 Code compiles.
    Need to start a test routine and find the bugs.
    [datapath.sv, datapath_stim.sv, regBlock.sv]
2014-02-18 Now uses the trisreg module.
    Done most the internal wiring
2014-02-18 Got a clock and reset.
    Need to come up with a formal set of tests
    [datapath_stim.sv]
2014-02-19 fixed one error message in rc and began automating synth process
    [control.sv]
2014-02-20 Started on testbench
    Currently exercises the PC and LR
2014-02-20 Tested loading into IR.
    Found an error.
    [datapath.sv, datapath_stim.sv]
2014-02-20 fixed wiring
2014-02-20 Initial Assembler Work
    [waves.dsn]
2014-02-20 Fixed the herp derp error @ashleyjr
    [cpu_core.sv]
2014-02-20 Basic program exercising some adds
    Assembler:
    ADDI $0 $0 #31
    ADDIB $1 #255
    ADD $2 $0 $1
    ADC $3 $2 $1
    ADCI $4 $3 #21
    @ashleyjr - all this is tied in in the simulation. Just invoke system level
    simulation and magic will happen
2014-02-20 Fixed blocking statements in combinational logic
    [control.sv]
2014-02-20 Corrected the IO to the module
    [cpu_core.sv]
2014-02-20 Got instructions loading into IR�.
    No writing data support yet. But it's a start!
2014-02-21 Removed lots of temp files.
    Also, added them to the .gitignore so they don't crop up again
    [waves.dsn]
2014-02-21 Made the opcode an enum
    Means it's a type and it shows up nicely in the waveform
    Only issue is that PUSH/POP and LDW/STW have to map to the same waveform, but
    I think this is fine given it makes the coder aware of them being the same and
    another bit must be checked to deduce if it is a LOAD/STORE or POP/PUSH
    [control.sv, cpu_core.sv]
2014-02-21 #17 - Stops assertions errors
    [control.sv]
2014-02-21 servers broke, going home
    [control.sv]
2014-02-22 Framework for program regression testing
2014-02-24 wiring issues.
    Getting some correct data now
    [control.sv, datapath.sv]
2014-02-24 Temp fix to get it running
    [alu.sv]
2014-02-24 Assembler pre run test
2014-02-24 Version 1 of the assembler.
    @ashleyjr - feel free to test.
    @mw92 - sorry, not much of your code made it! too many bugs...
2014-02-24 added some prints to help see why things go wrong when they do
2014-02-24 Now invokes compiler
    If the program given has an assemble equivalent (.asm) it will compile this before running the simulation
2014-02-24 Test assembler code
2014-02-25 restore original assembler as git didnt pull correctly
2014-02-27 pre-lab 27Feb Assembler
2014-02-27 Assembler Lab 27Feb - mc translation next
2014-02-27 Missed a bit of stack shit
    [control.sv]
2014-02-28 Corrected an error in the alu
    also added errors to waveform and prints a pass or fail output
    [alu.sv, alu_stim.sv]
2014-02-28 Added testing of flags.
    V flag is currently wrong in alu.sv. Bug #44
    [alu.sv, alu_stim.sv]
2014-03-01 Corrected ALU flag.
    Added another test case. ALU now detects overflow. Fixes #44
    [alu.sv, alu_stim.sv]
2014-03-02 Assembler finished
2014-03-02 Assemble output hex too
2014-03-02 handin assembles multiply
2014-03-03 Added SP recognition to Assembler
2014-03-03 Got an interrupt working.
    Enters a new state. Need to implement it actually doing something now though...
2014-03-03 Okay, so- Got an interrupt triggerring the PC to save to the Stack.
    Looking good.
    No extra instructions implemented as of yet.
    Job for tomorrow is to add a jump to constant, stored in either DP
    or control.
    Need to sort memory hold violoations that I am getting.
    @ashleyjr - what causes a memory hold violation?
2014-03-04 #27 - hasn�t followed sim file but this works a bit better
2014-03-04 #50 - Quick and dirty to get interrupts submission up and running
2014-03-04 In the wrong branch
    [interrupt.asm]
2014-03-05 multiply sv assembler
2014-03-05 Assembler set to 16 wide hex
2014-03-05 My assembly for testing ISR during dev. #54
    Won't compile this file
    [multiply.asm]
2014-03-05 more int prog, blind of assembler
2014-03-05 Multiplication Code with an interrupt.
    The ISR just pulls some data from memory, increments it and stores it back.
2014-03-05 Interrupts working!
    It will go to Address 16 when interrupted and return to PC when complete.
    Pc is stored to the stack.
2014-03-05 Made the interrupt appear later
2014-03-05 Implemented the Enable and Disable interrupts. #50
    All left to do is sort address problems hold issues
    Also, removing magic numbers used would be wise
    [control.sv]
2014-03-05 #50 - Solved one memory hold issue
    [control.sv]
2014-03-05 Assembler V5 - help support
2014-03-05 #50 All memory violations solved
    [control.sv]
2014-03-05 Assebler V6 - interrupt support
2014-03-06 stall slow mem in fetch
    [control.sv]
2014-03-06 wire it up
2014-03-06 RET in R0 bug?
    [factorial.asm]
2014-03-07 corrected some small errors found.
    Whole block remains untested. Power outage imminent
2014-03-08 Lots done.
    Started a slice17 file, which will have the decoders and such in.
    All is really left to do is the labelling (sysbus) and some wiring (Ir to muxes etc)
    Won't do this until ALU is done as sizes of slices could change and have to do it again.
2014-03-09 Assembly ints on handin
2014-03-10 Fixed multi for ints
    [multiply.asm]
2014-03-10 ALU Testing - Shifting Problem
    [ALUSlice.sv, ALUSlice_stim.sv, ALU_16Slice.sv, ALU_16Slice_stim.sv]
2014-03-10 ALU Module Passes Current Tests
2014-03-11 ALUDecoder stim ready for testing fixes
    [ALUDecoder_stim.sv]
2014-03-11 ALUDecoder before logic corrections
    [ALUDecoder_stim.sv]
2014-03-11 Corrected some stuff for cross sim
    [cpu_core.sv, options.sv]
2014-03-12 Synthesised aludecoder. @mw92
    [aludecoder_IO.cfg]
2014-03-12 ALUDecoder_new LUI is now correct
    [ALUDecoder_new_stim.sv, ALU_16Slice_stim.sv]
2014-03-13 Can now probe nReg7
2014-03-13 Added more probes
2014-03-13 Control IO
    [control_IO.cfg]
2014-03-13 @seblovett - control de-fuck
2014-03-13 place and route
    [control_IO.cfg]
2014-03-13 Moved datapath.sv to permanent home. Added more probes.
    Interrupts serial hex file included too
2014-03-14 Both sims work with one interrupt.
    Second interrupt messes things up and not sure why...
2014-03-14 Behavioural working again with Interrupts.
    Need to add override to ALUDecoder to allow for Inc and Dec functions
2014-03-14 First control synth
    [control_IO.cfg]
2014-03-14 Added defines for Interrupts subcodes. Closes #69
2014-03-15 Reduced vertical size of wiring.
2014-03-15 Refreshed all cells and connected wires
2014-03-16 Removed label issue and added serial to sim.py
    [factorial.asm, interrupt.asm]
2014-03-16 #73 - @seblovett I think 4a fails because multiply.txt was out of date, also we had two identical labels in interrupts.asm which the assembler doesn't catch -> #54
2014-03-16 Experimenting with layout
    [control_IO.cfg]
2014-03-18 Found Issue with SP not incrementing properly during interrupts
    @ashleyjr, it was an error in the alu.sv not taking the Carry In into account.
    All works now. Fixes #79
    [alu.sv]
2014-03-19 Clean up and remove preprocessor statments which we no longer care about
    [control.sv]
2014-03-20 Added control.mag
    made from LEdit place and route
2014-03-21 corrected wiring issues
2014-03-21 fixed Data undefined error.
    Assertions still fire, however. #82
    [control.sv]
2014-03-21 Script to synth control and convert to edf for LEdit
2014-03-21 Added pad ring used.
    To be kept up to date with current size used
2014-03-23 Fixed #84.
    In last cycle, Pc drives sysbus
    [control.sv]
2014-03-24 Reordered interrupt substates.
    Will hopefully solve glitches
    [control.sv]
2014-03-24 cleaned interrupts up a bit
2014-03-24 Fixed sysbus driving issues.
    [control.sv]
2014-03-25 Fixed control.sv
    Error was with the Flag restore and RETI not returning correctly
    [control.sv]
2014-03-25 Full pad ring works!
    Both multiply and interrupts work fully!
    Next steps are to fit pad ring, neaten and test!
2014-03-27 Bus contention issue found
    [control.sv]
2014-04-03 Assembler V8 & datapath_stim
2014-04-03 fixed assembler ISR ending
2014-04-03 Assembler supports defines
2014-04-04 Routed power
2014-04-05 Reduced size of pad ring. Routed power to correct size
2014-04-05 PG Assembler section mostly done & assembler updates
2014-04-07 Update for auto SP and ERROR4 output
    [factorial.asm, interrupt.asm, multiply.asm, random.asm]
2014-04-07 Added a special monitor file and corrected some bus contention issues
    [control.sv, monitor.sv]
2014-04-07 Gate level synthed correctly
    [control.sv]
2014-04-07 Functional. Getting assertions firing left right and centre, however. I suspect something to do with the interrupt flags instructions. Will investigate tomorrow
2014-04-08 Routed GND properly
2014-04-09 ALU now supports n,z flags correct always
    [datapath.sv]
2014-04-11 Most of the lonely vias are solved. Some remain in the haystack that is the control wiring channel.
2014-04-11 Had to modify rowcrosser
    There was an issue with the scanreg next to a rowcrosser with the XP_4 drc.
    Solved this by adding a ground wire with tap on the end in the rowcrosser
    cell.
    Means all cells have been updated.
    CPU passes all XP_4 issues now and sims okay
2014-04-11 Combined all design files into one folder to match Iains directory structure.
    [aludecoder_IO.cfg, control_IO.cfg]
2014-04-12 PG Updated to new Assembler
2014-04-13 Gone through assembler section. @mw92, please read my comments. #92
2014-04-14 PG: IS and Assembler update
2014-04-24 Found bug in ADCI
    [control.sv, multiply.asm]
2014-04-25 I have corrected the assembler usage section #92
    Added a check to see if a filename has been input to the script.
    If not, help is printed and the script exits
2014-04-25 Assembler V11: Setup code shortened, numeric branch support removed
2014-04-25 Assembler V12 ongoing
2014-04-25 Assembler V12: All branches are unbounded
2014-04-25 assembler v tweak
2014-04-26 Fixed Assembler
2014-04-26 Assembler jumps over ISR not to last line
2014-04-27 Corrected a syntax error in monitor.sv.
    Added more to the TCL files
    [monitor.sv]
2014-04-27 PG: Assembler info updated to V12
2014-04-28 Assembler sets SP to location after program, better handling of no ISR
2014-04-28 Fixed assembler again
2014-04-28 Assembler no longer uses stack for jump over ISR
2014-04-28 Compiled. Printing this one for a read through
2014-04-28 Added switches support @ashleyjr
2014-04-28 #75 I have added switch and trailing argument support for sim.py
2014-04-28 #98 - bug in NEG
    [fullCoverage.asm, random.asm]
2014-04-28 BUGS in SUC and SUCI
    [control.sv, fullCoverage.asm, interrupt.asm]
2014-04-28 undo assemble change
2014-04-28 Added a style for printing SAMURAI. Can be easily changed if needs be.
2014-04-29 Assembler V13: improved error resolution
    [interrupt.asm]
2014-04-29 #92 done more on tips.
    Added some example code for branching.
    Reference to assembler section added too
2014-04-29 Updated magic and stim files for adjustments made a while ago so they now simulate correctly
    [ALUDecoder_new.sv, ALUDecoder_new_stim.sv, ALUSlice.sv, ALUSlice_stim.sv, ALU_16Slice_stim.sv]
2014-04-30 #75 changed to use assembler dir in the fcde set up as base. Paths are relative
2014-05-01 Solved all compiler warnings
    [cpu_core.sv, options.sv]
2014-05-01 Small assembler update
2014-05-01 PG: assembler error screen shot
2014-05-01 Added LEDs and switches to TCL
2014-05-02 Sorted extracted issues with new hierarchy
    [cpu.sv]
2014-05-02 Assembler: reduced ISR handling lines
2014-05-03 Added plot of the chip design. @ashleyjr - happy to go print this at some point with you!
2014-05-03 Added regBlock slice schematic.
    [regBlock_slice.sch]
2014-05-03 #96 - added PcBlock Slice schematic
    [PcBlock_Slice.sch]
2014-05-03 #96 - added Ir schematics
    [IrAA.sch, IrBA.sch, IrBB.sch]
2014-05-03 Schematic for the register decoder
    [decoder.sch]
2014-05-04 Added figure and a little more text to Pc section #96
    [PcBlock_Slice.sch]
2014-05-05 Started datapath design #96
    [datapath.sch]
2014-05-05 Done a little more on the datapath and draft of the CPU design.
    Can't think of much more to put in the CPU design. #96
    [datapath.sch]
2014-05-08 Most ALU circuit diagrams
    [ALUDecoderGateArray.sch, ALUDecoderMore1.sch, ALULib.sch, ALUTopLevel.sch, AbstractALU.sch, ArithSlice.sch, LLILSlice.sch, LogicSlice.sch]
2014-05-08 White noise test working. #104 #96
    Though it shows we have an error in the CPU...
    [monitor.sv]
2014-05-09 FR:ALU design reduction and rewording
    [ALUDecoderGateArray.sch, ALUDecoderGateArrayv2.sch, ALUDecoderMore1.sch, ALUDecoderMore1v2.sch, ALUModular.sch, ArithLogicSlice.sch, ArithSlice.sch]
2014-05-09 interrupt sch
    [Interrupt.sch]
2014-05-10 cont IF
    [ControlIF.sch]
2014-05-10 Completed part on white noise test
    [monitor.sv]
2014-05-11 Eagle schematics now use library
    [ALUDecoderGateArrayv2.sch, ALUDecoderMore1v2.sch, ArithLogicSlice.sch, ArithSlice.sch, LogicSlice.sch, ShiftSlice.sch]
2014-05-12 Schematics small improvements
    [ALUDecoderGateArrayv2.sch, ALUDecoderMore1v2.sch, ALULib.sch, ALUTopLevel.sch, ArithSlice.sch, LogicSlice.sch, ShiftSlice.sch]
2014-05-12 schmatic update
    [ControlIF.sch]
2014-05-12 Eagle figures finished
    [ALUDecoderGateArrayv2.sch, ALUDecoderMore1v2.sch, ALUTopLevel.sch, AbstractALU.sch, ArithSlice.sch, ShiftSlice.sch]
